CallumNunesVaz/OpenController/README.md

# OpenController

A cheap, open-source general purpose controller based on a ubiquitous co-processor model.
