CallumNunesVaz/OpenController/Output/Documents/Schematic Prints.PDF

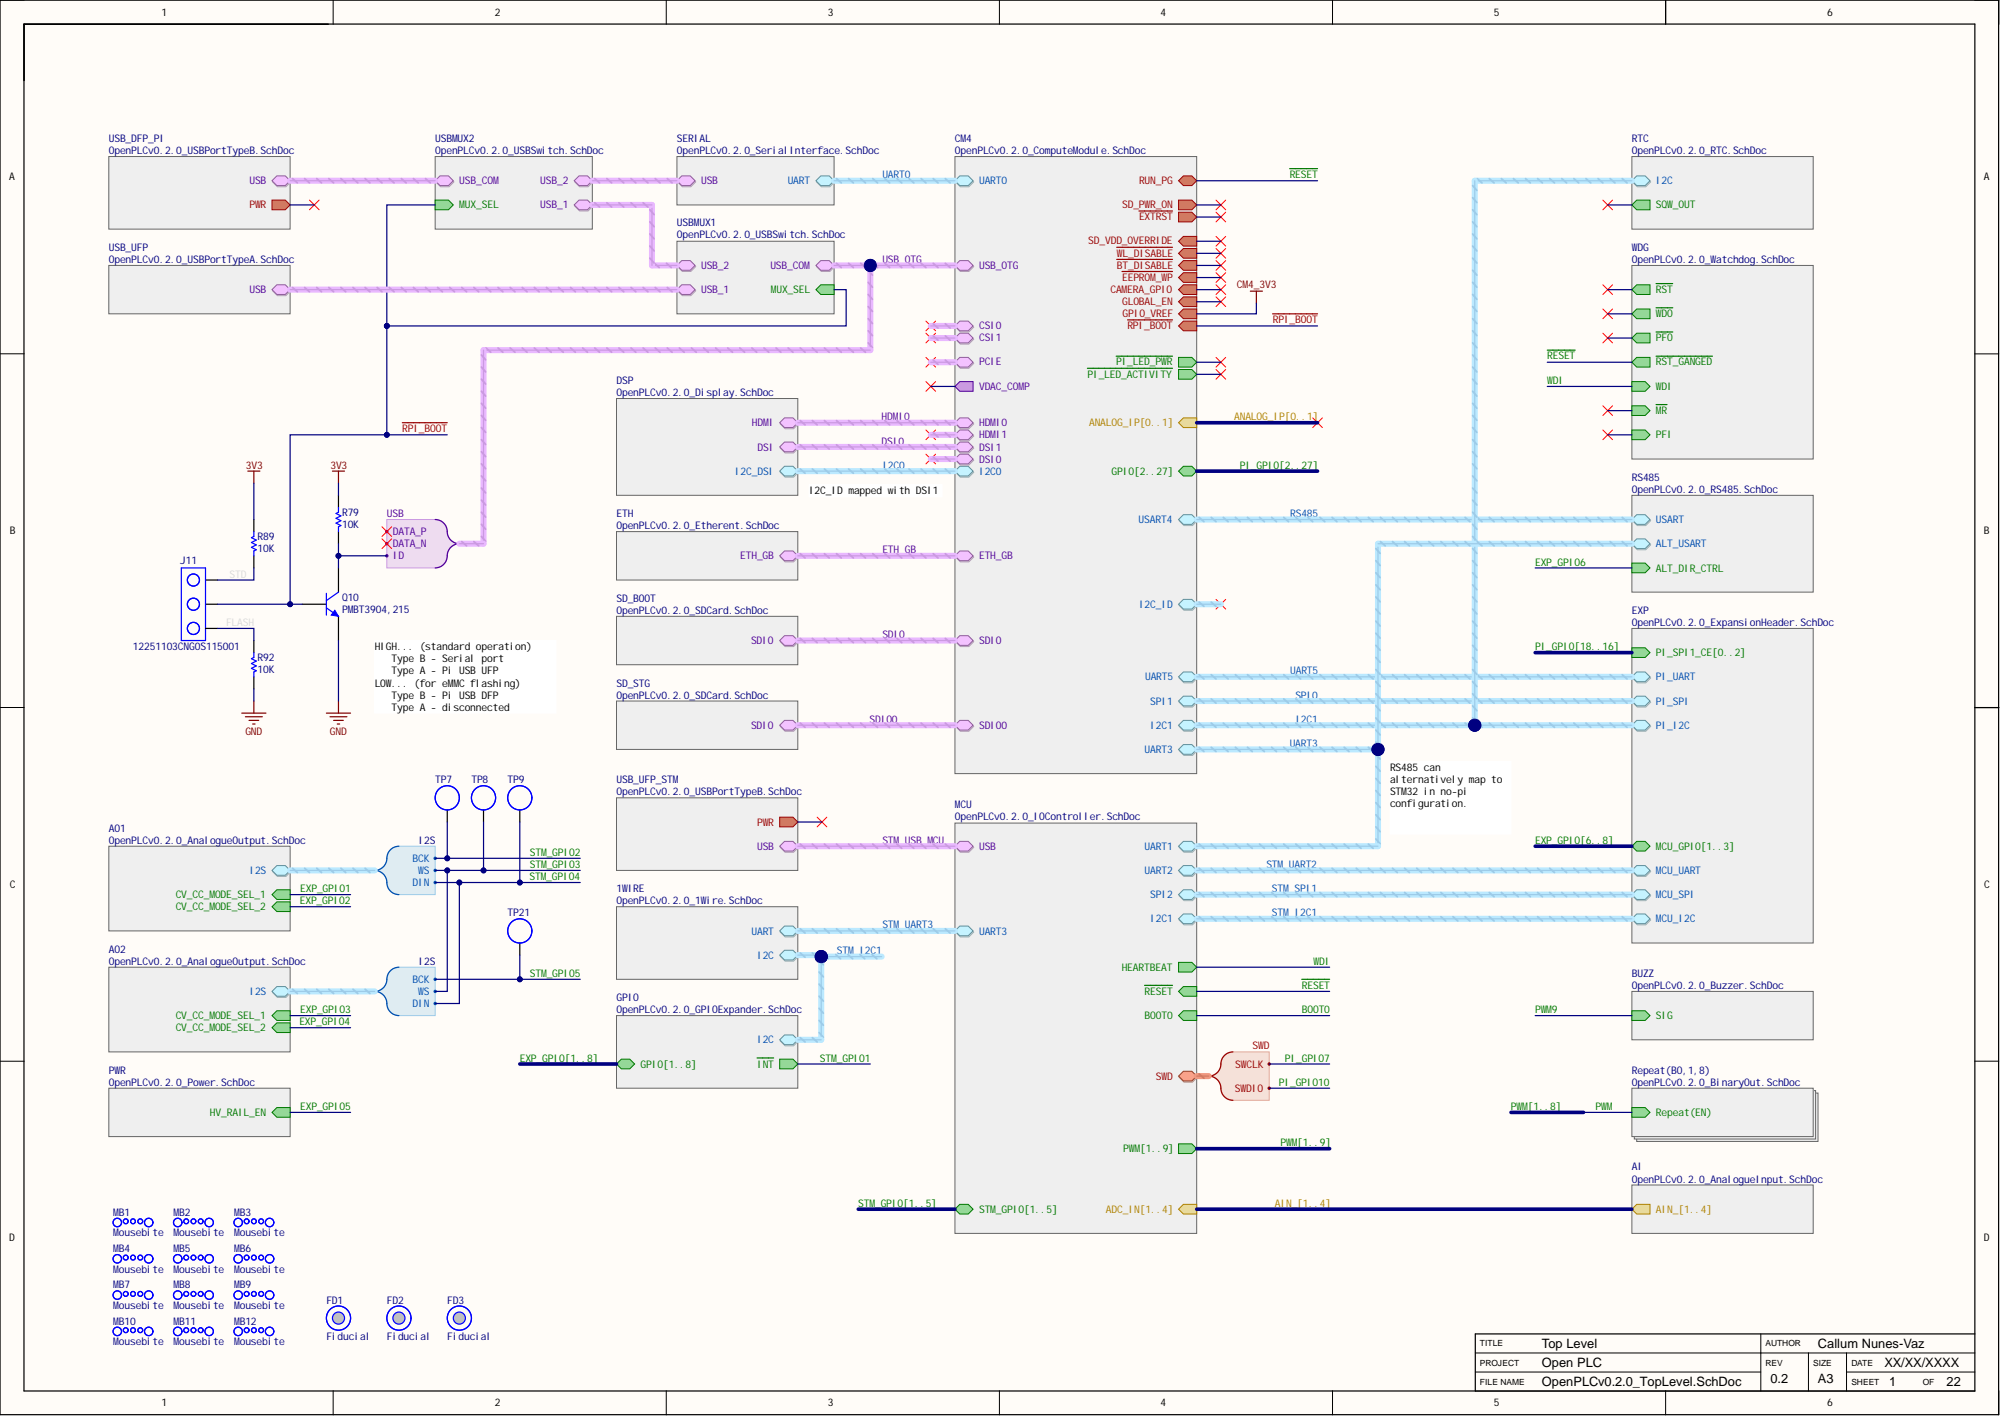
[picture p1: page 1]

HIGH... (standard operation)
Type B - Serial port
Type A - Pi USB UFP
LOW... (for eMMC flashing)
Type B - Pi USB DFP
Type A - disconnected

Top Level TITLE | Callum Nunes-Vaz AUTHOR

PROJECT Open PLC | REV | SIZE A3 | DATE XX/XX/XXXX
FILE NAME OpenPLCv0.2.0_TopLevel.SchDoc | | | SHEET 1 OF 22

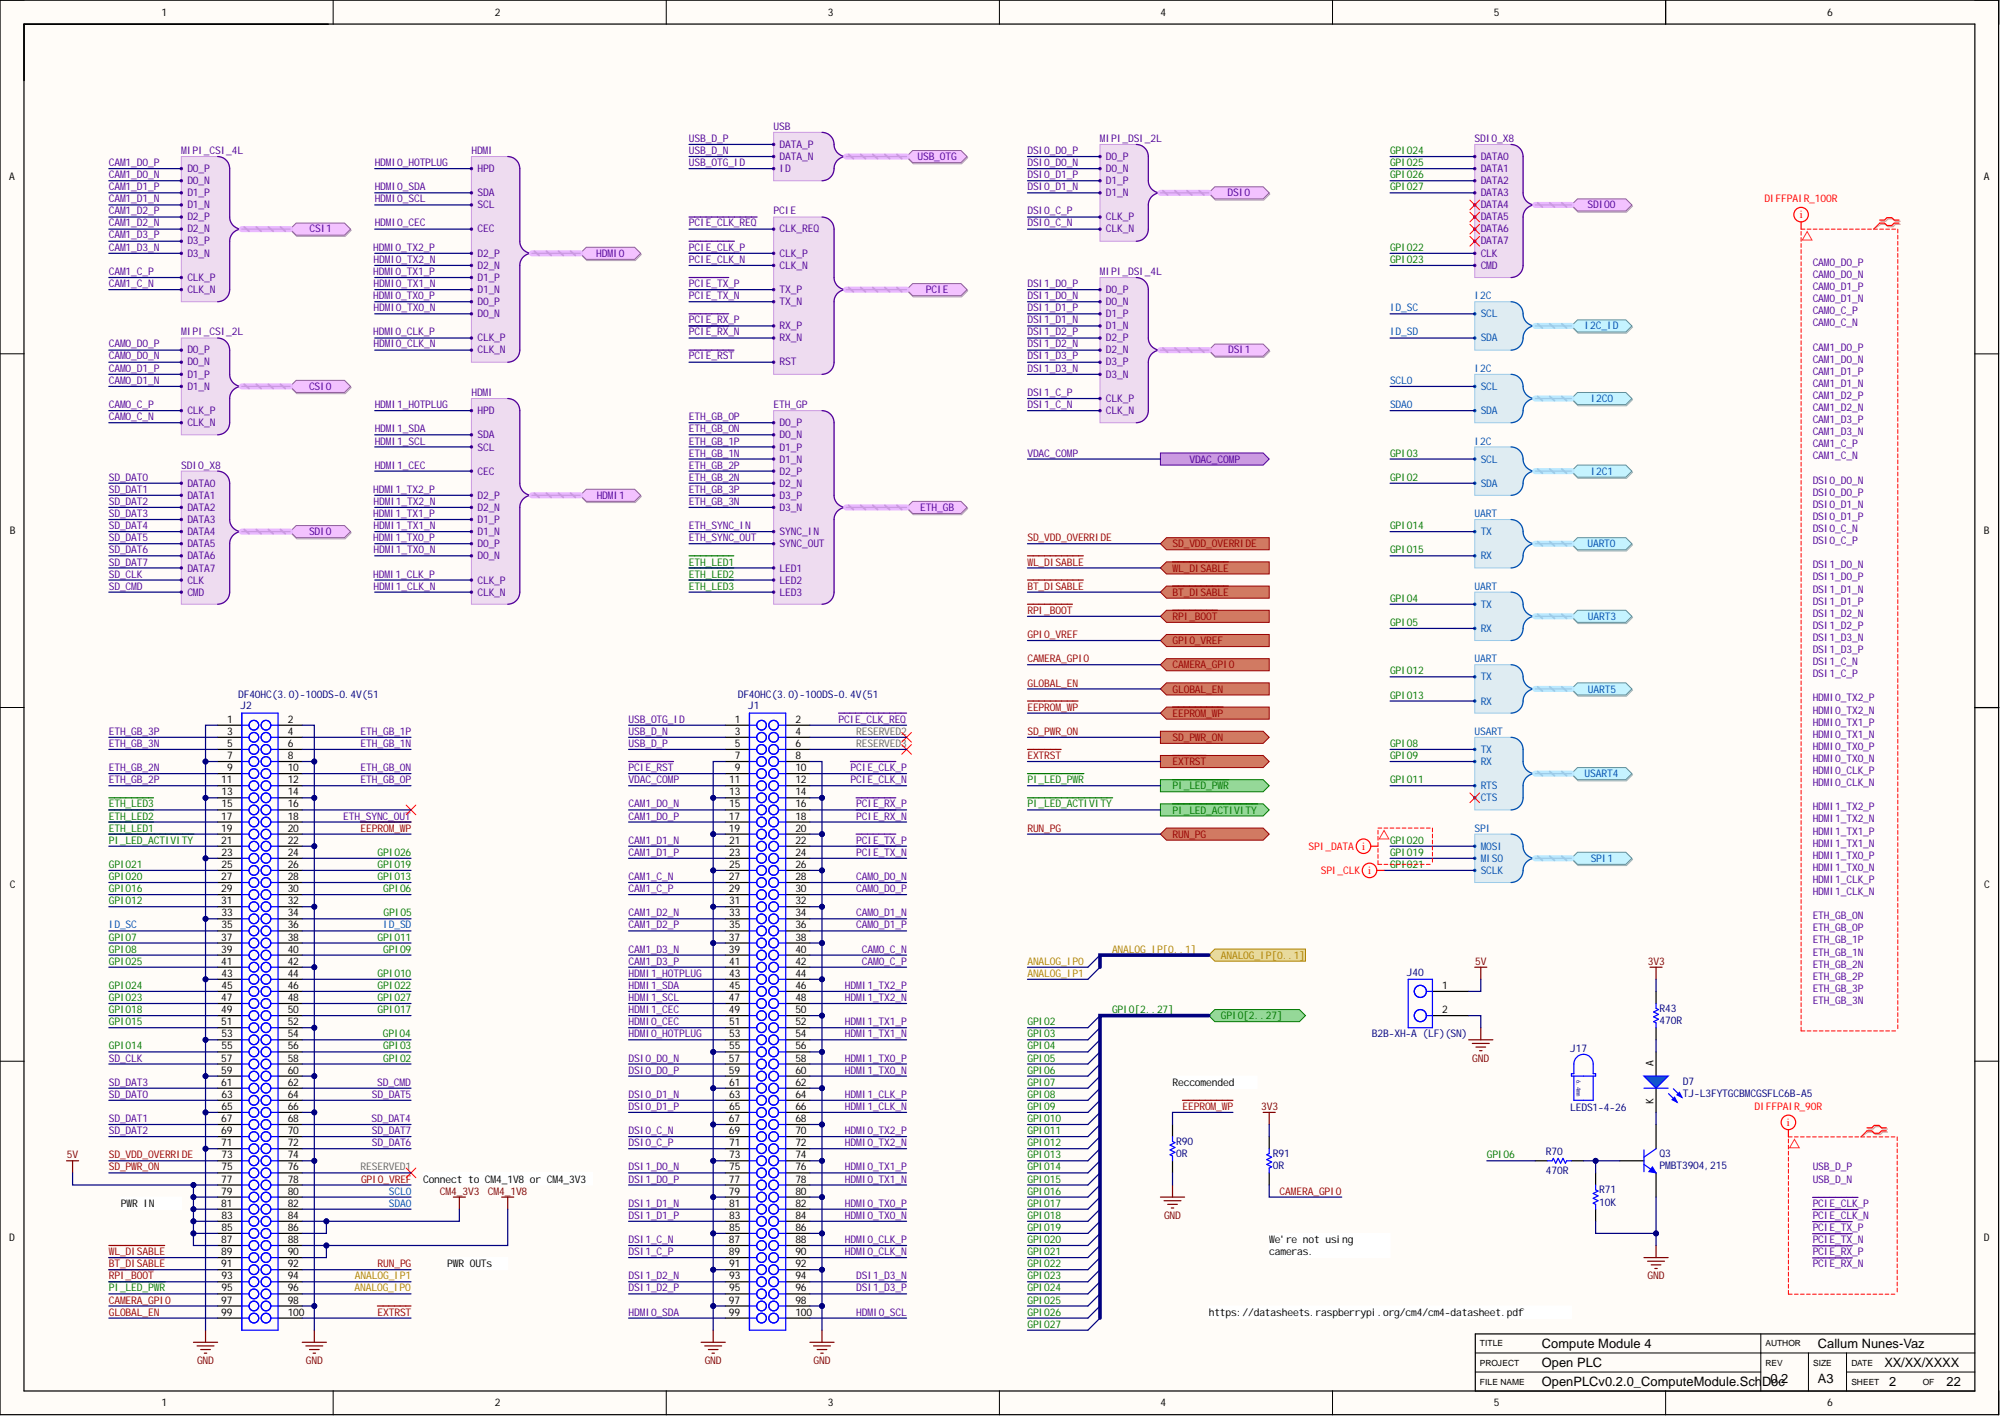
[picture p2: page 2]

Compute Module 4 TITL E | Callum Nunes-Vaz AUTHO R

PRO JECT | REV | SIZE | DATE A3 X X/X

FILE NAM E OpenPLCv0.2.0_ComputeModule.SchDoc | | | SHEET O F 22

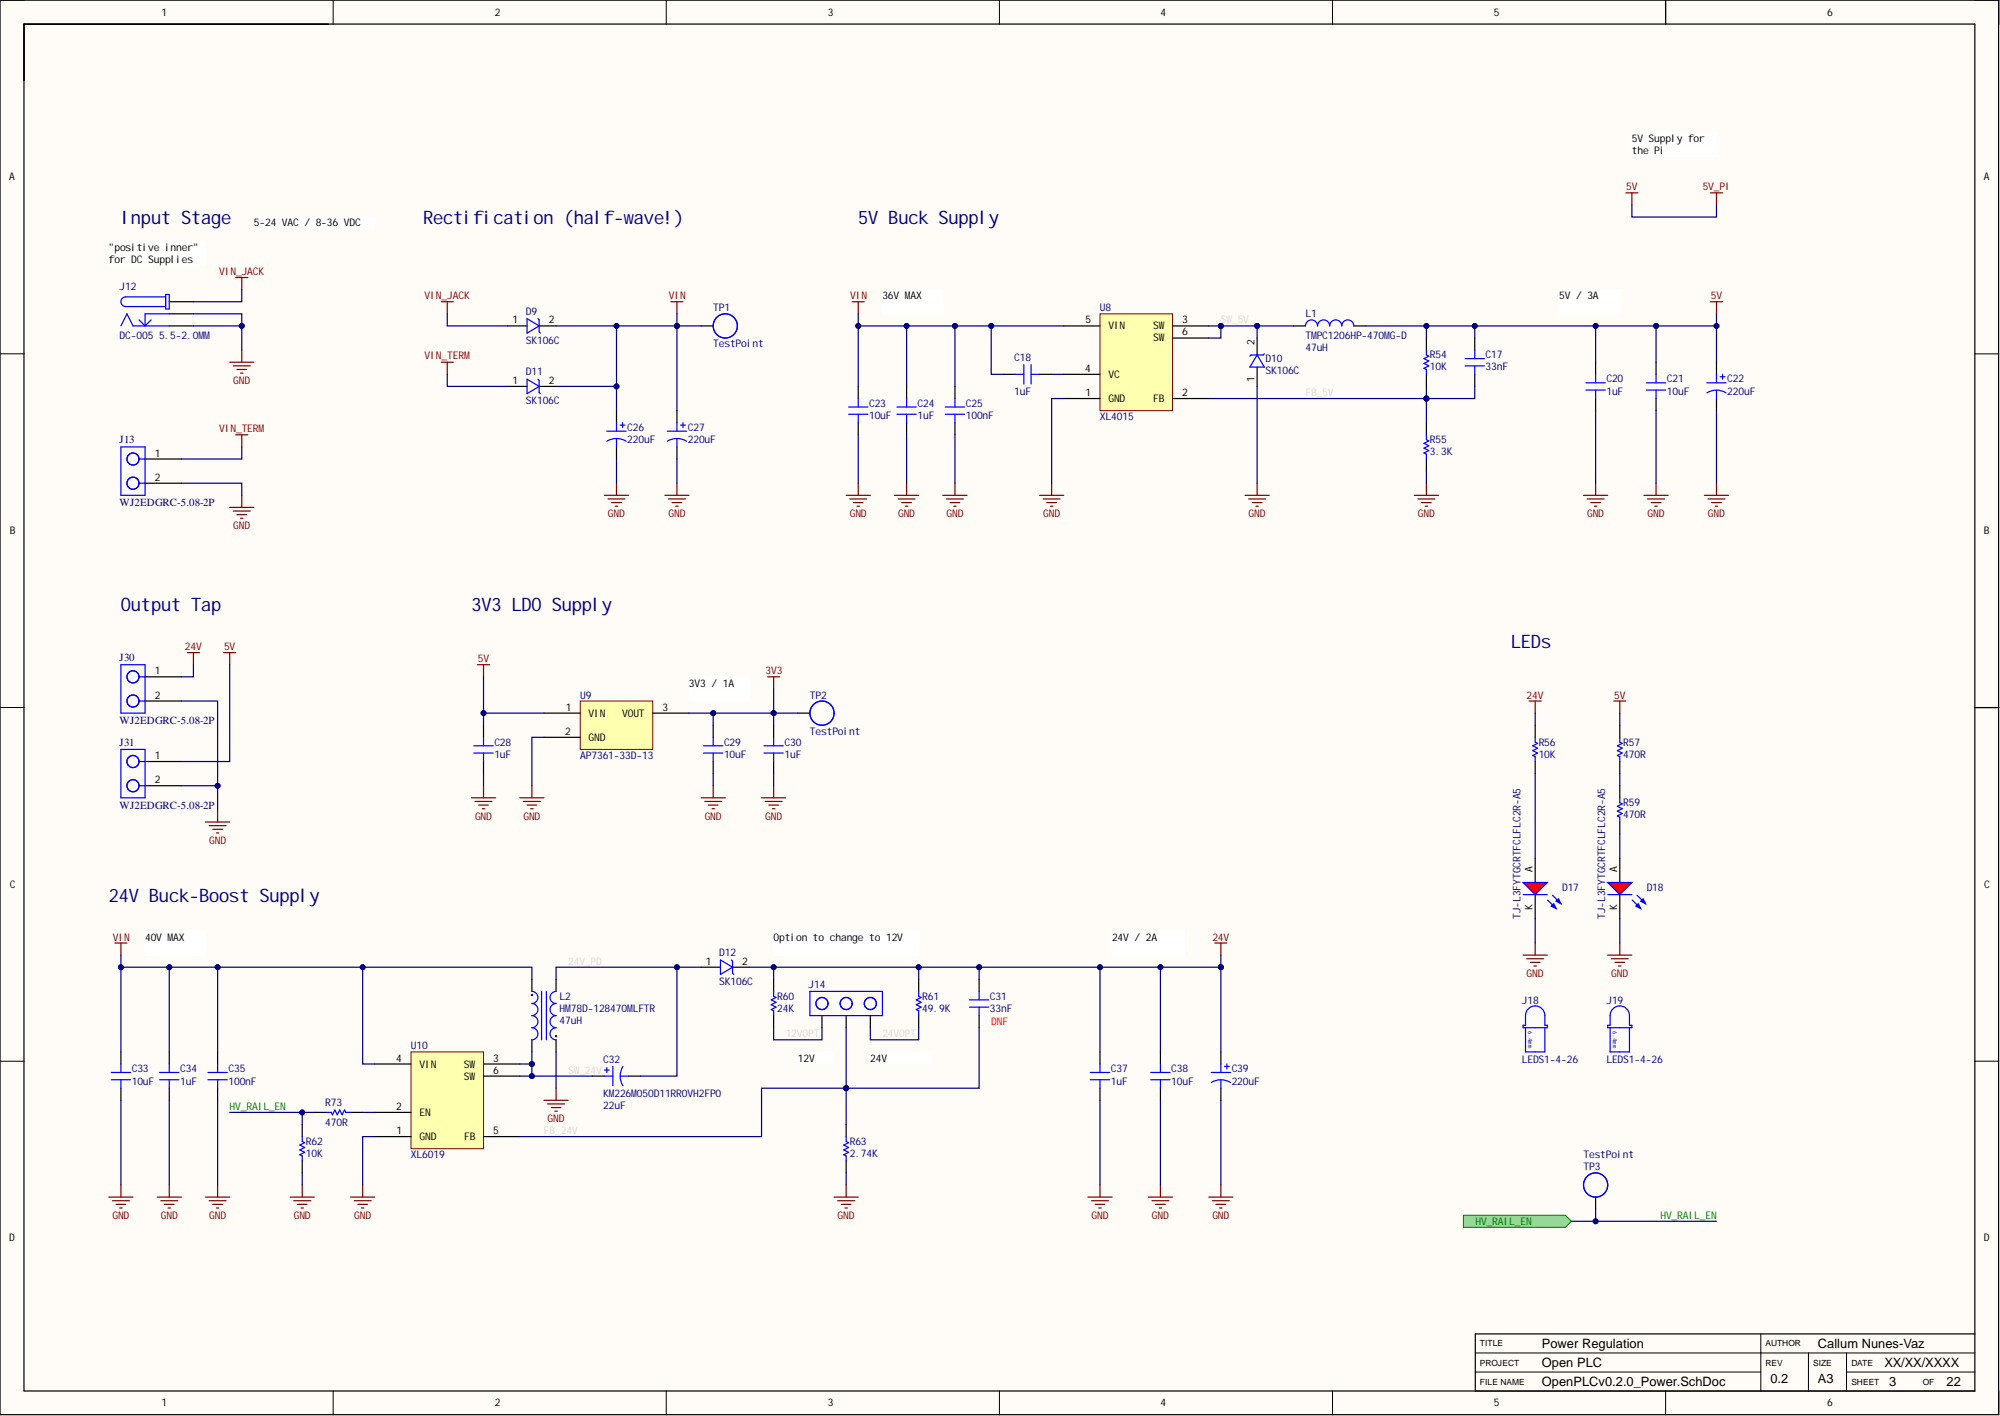
[picture p3: page 3]

Option to change to 12V

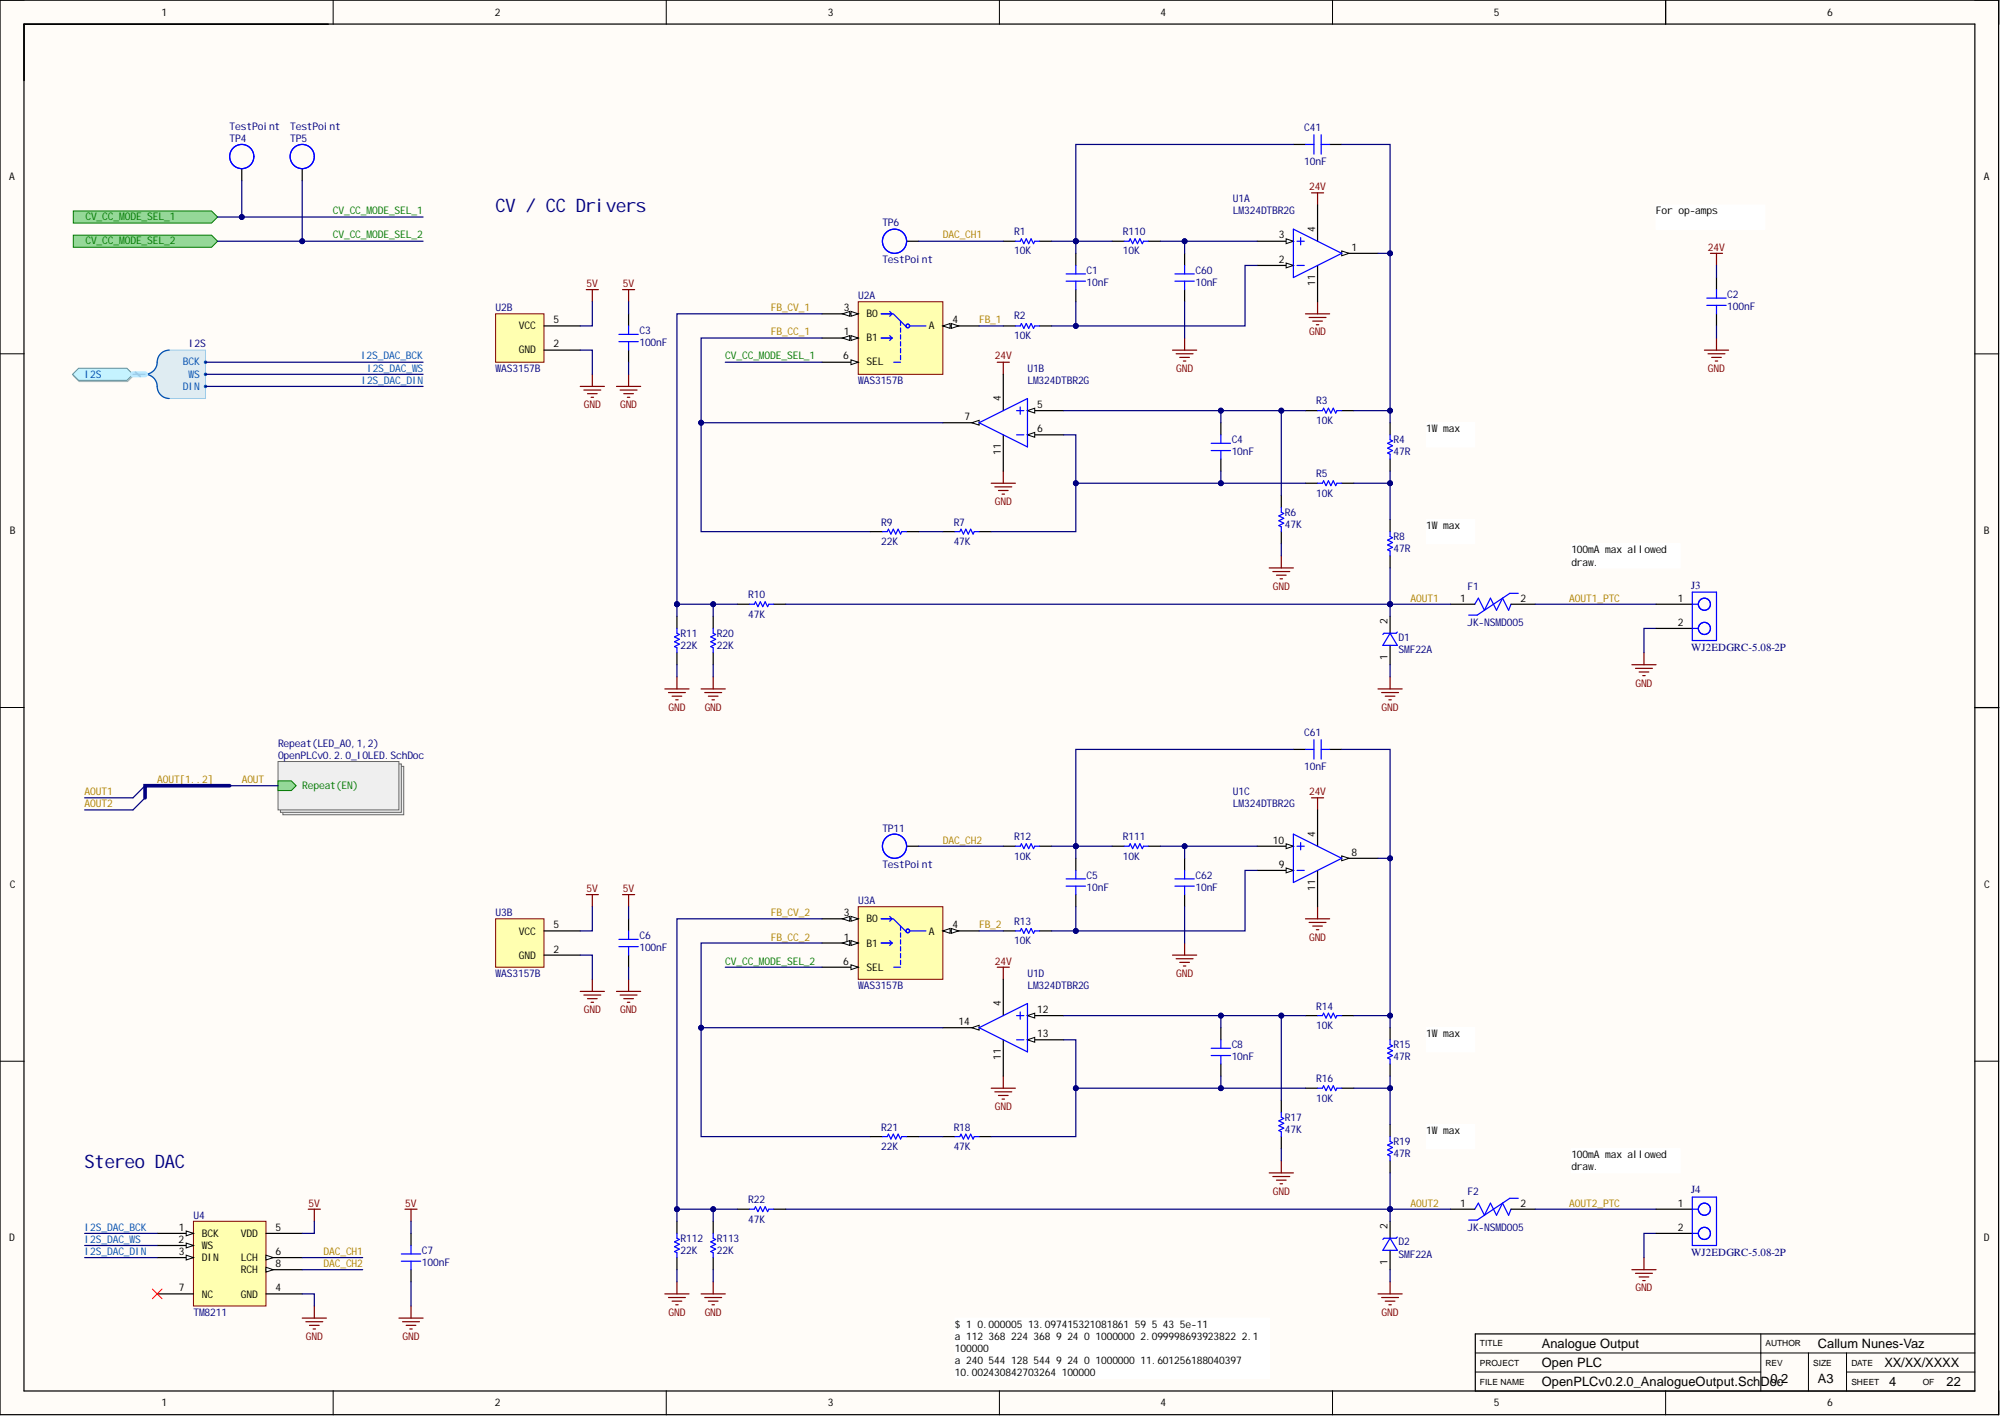
[picture p4: page 4]

CV_CC_MODE_SEL_1 | SEL 6

CV_CC_MODE_SEL_2 | SEL 6

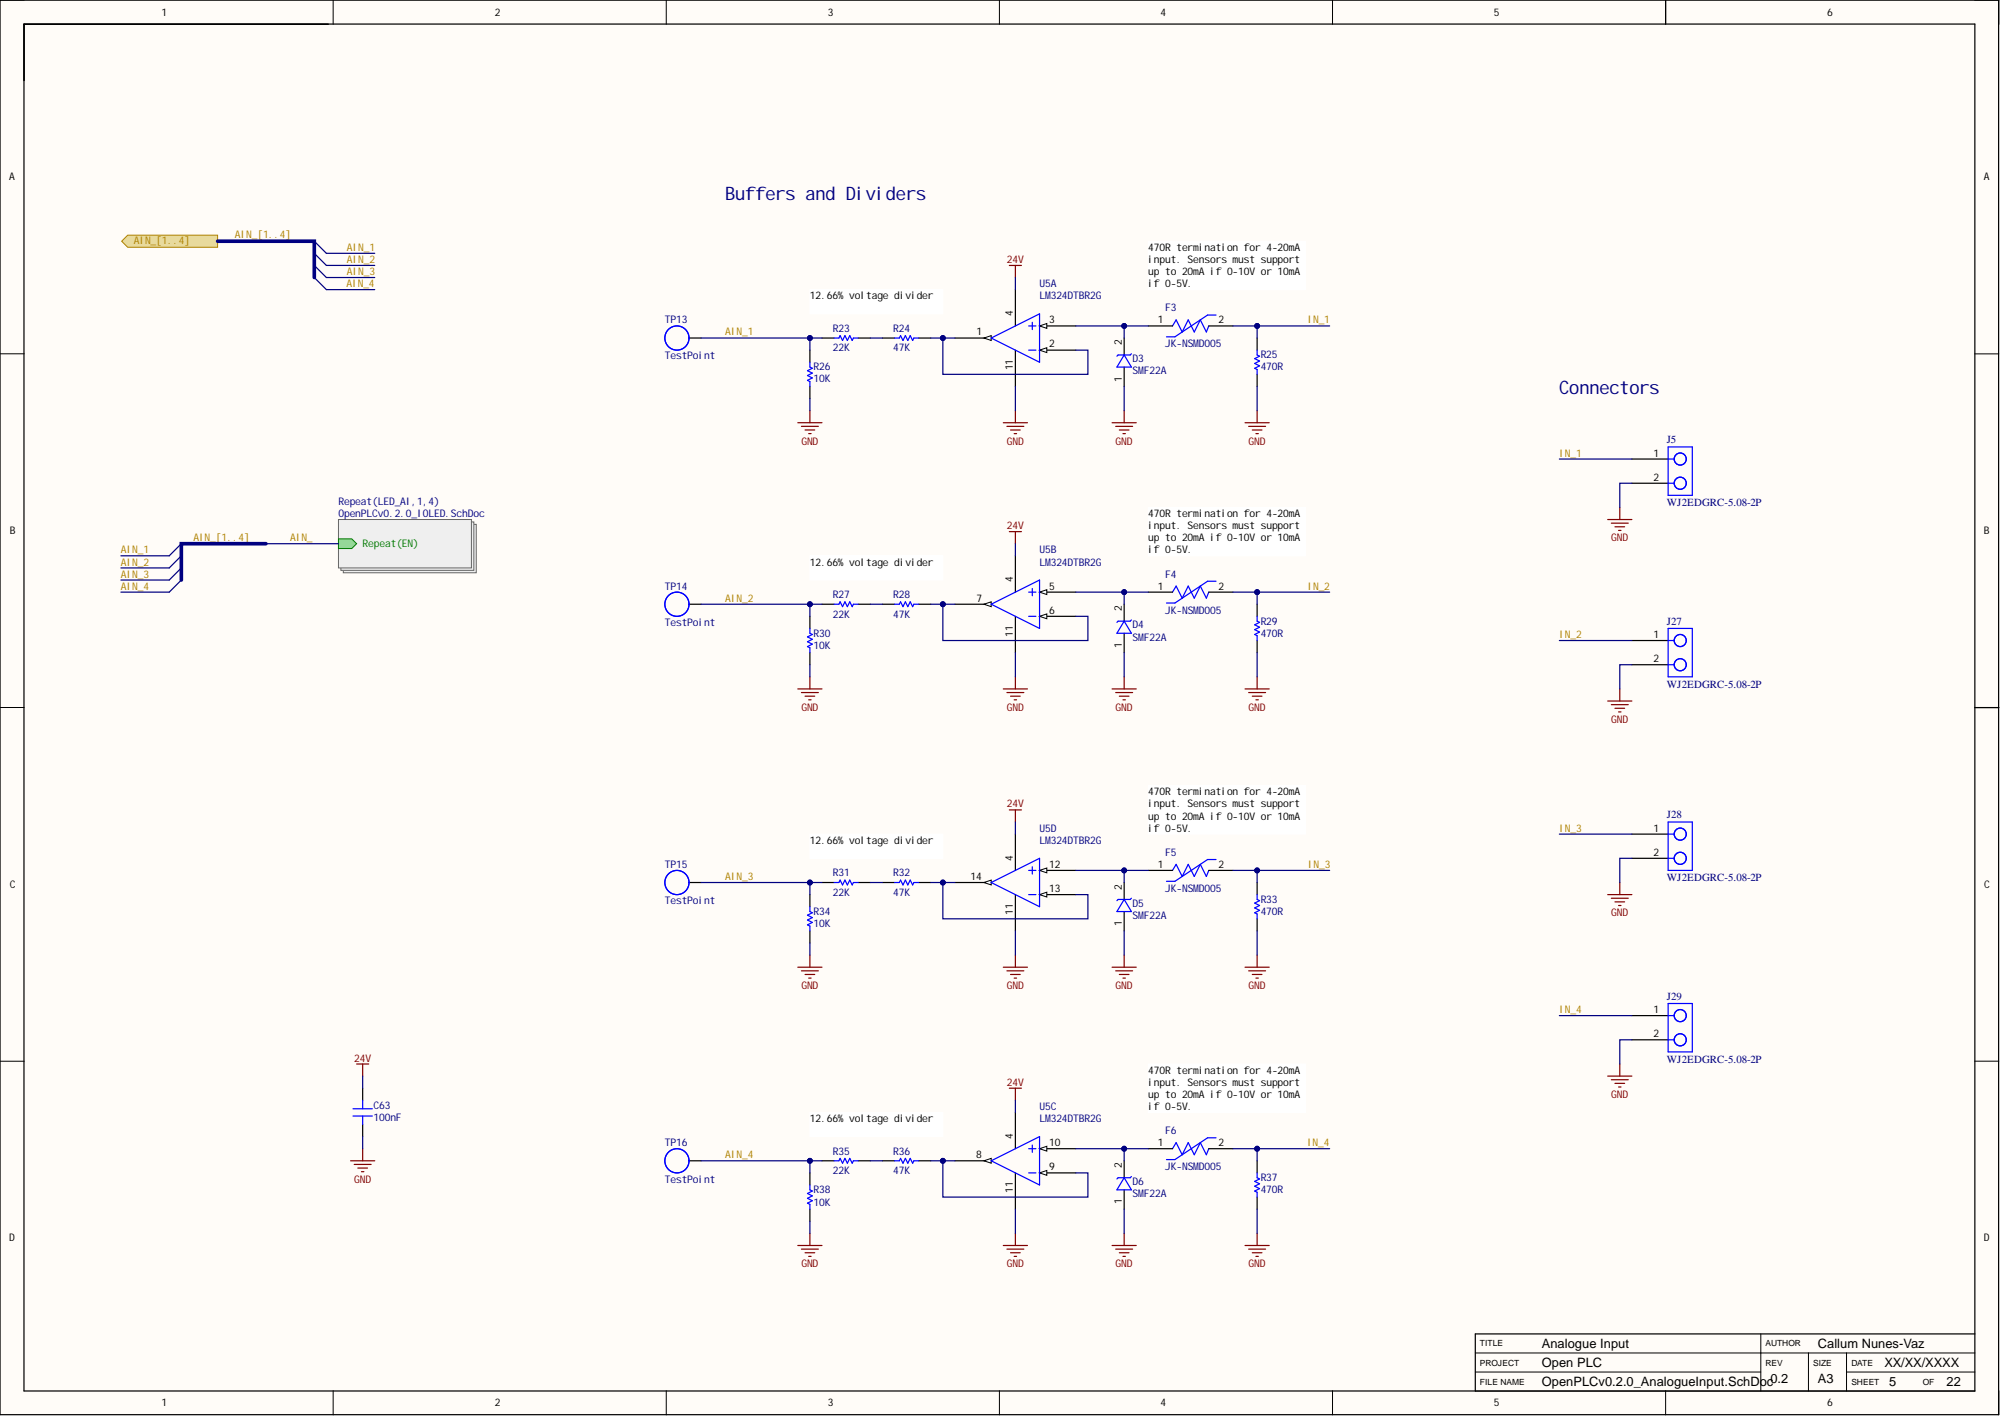
[picture p5: page 5]

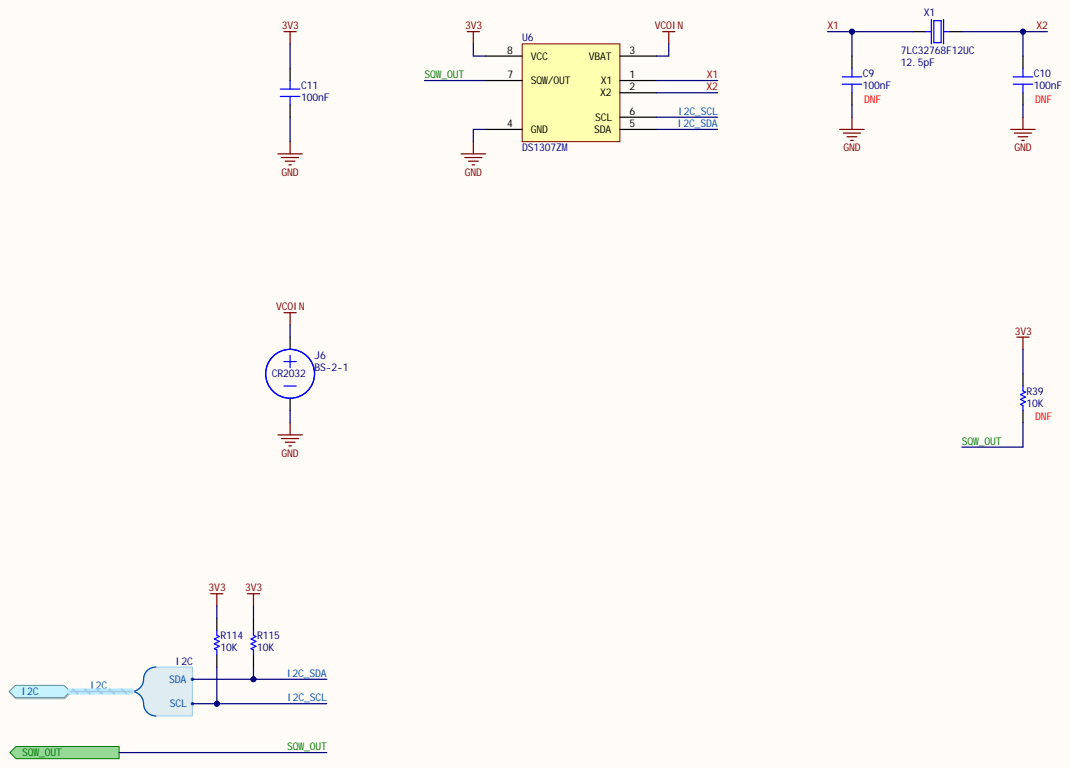
[picture p6: page 6]

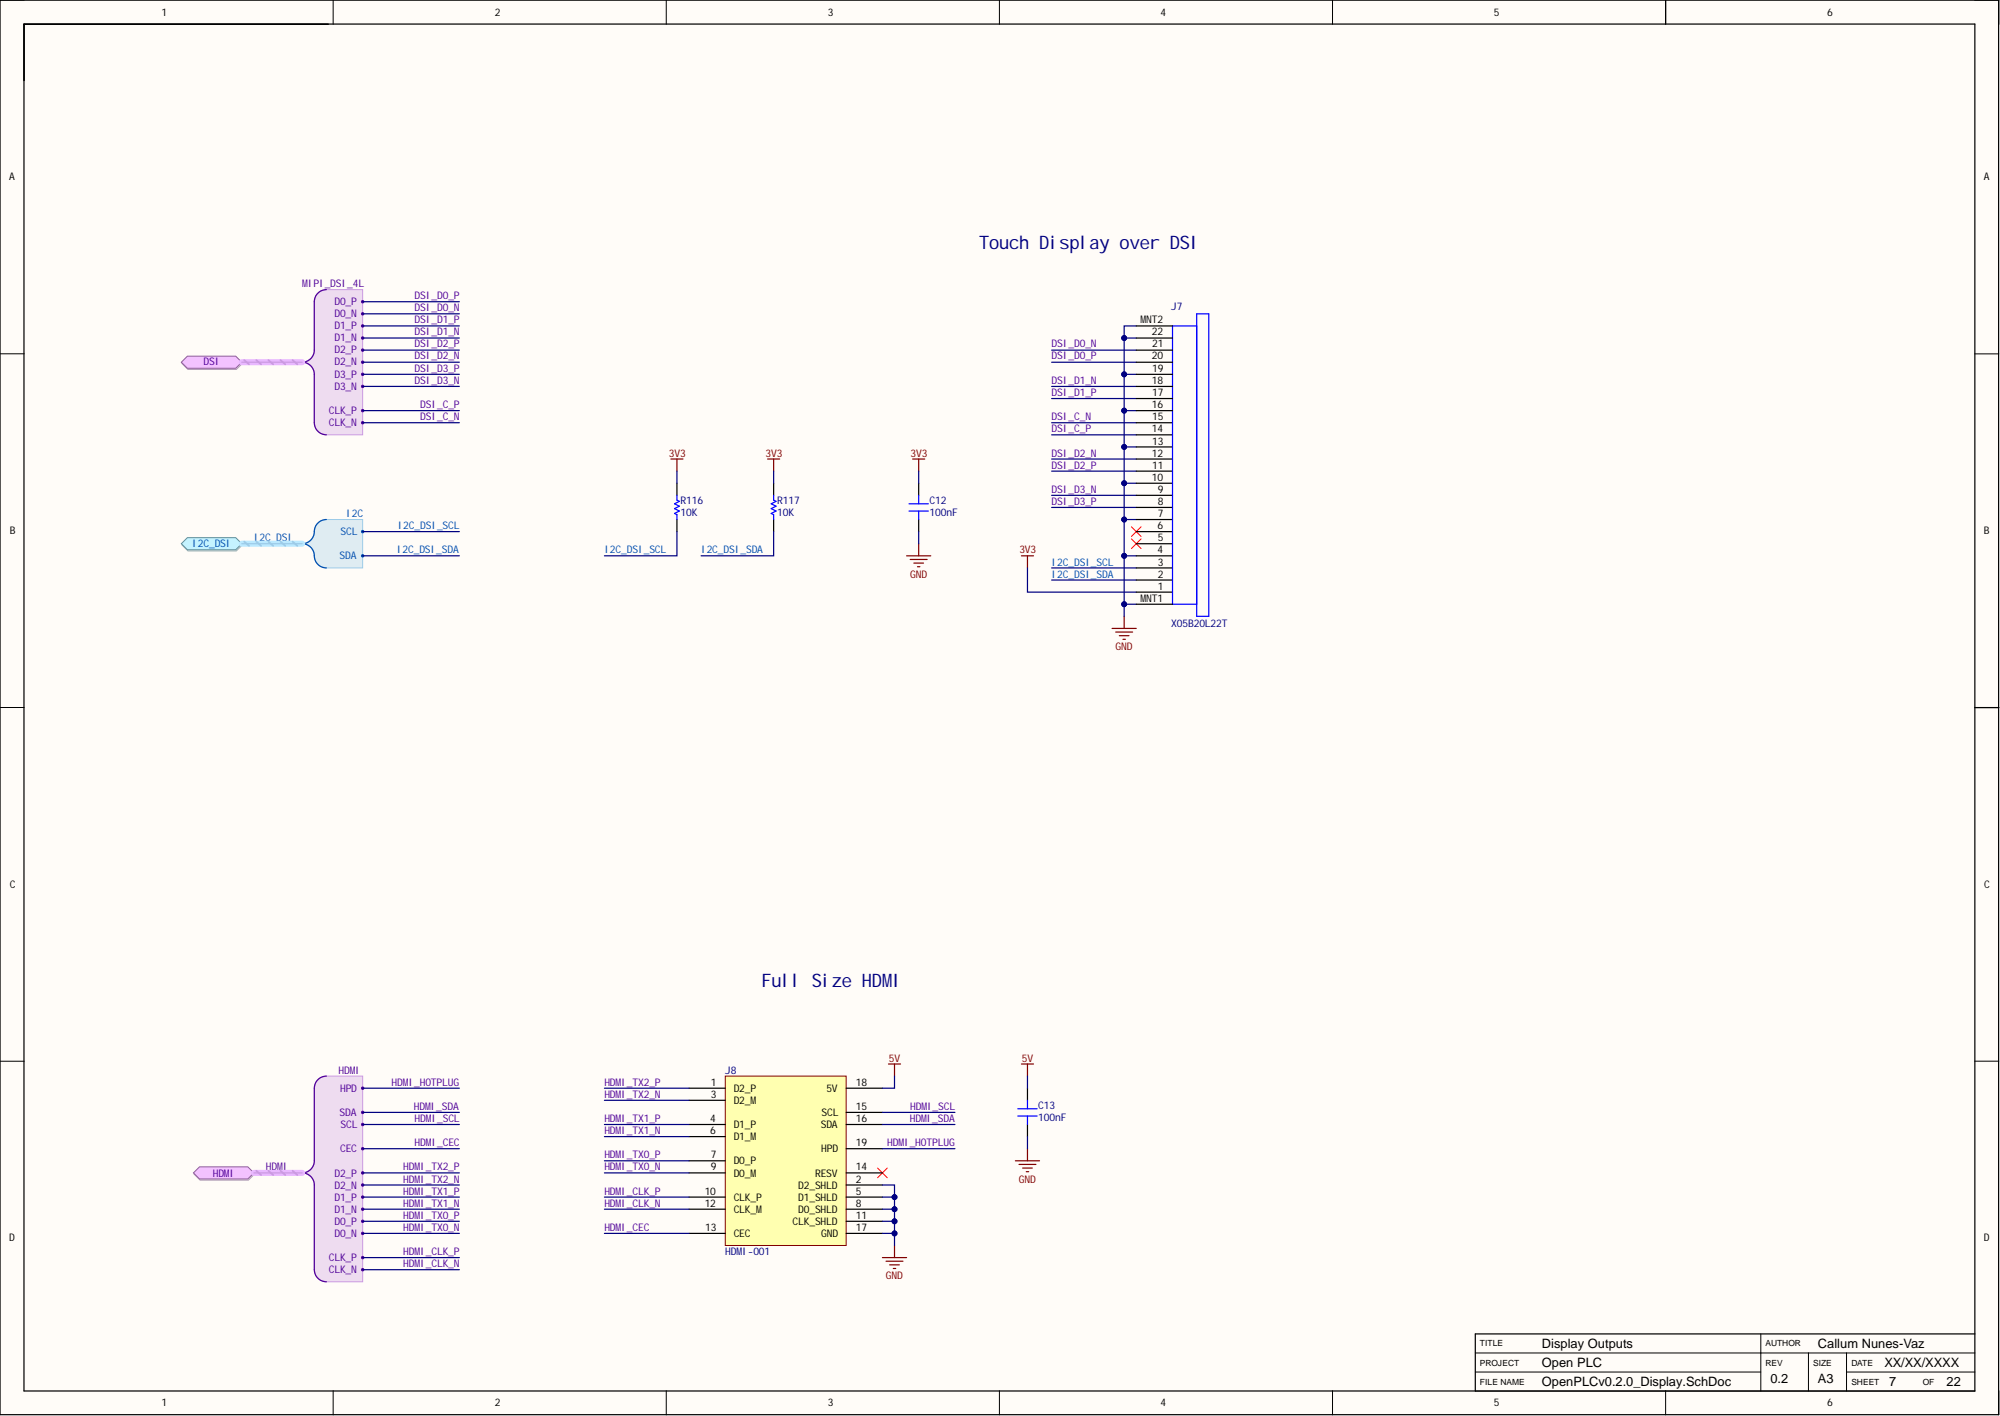
[picture p7: page 7]

Touch Display over DSI

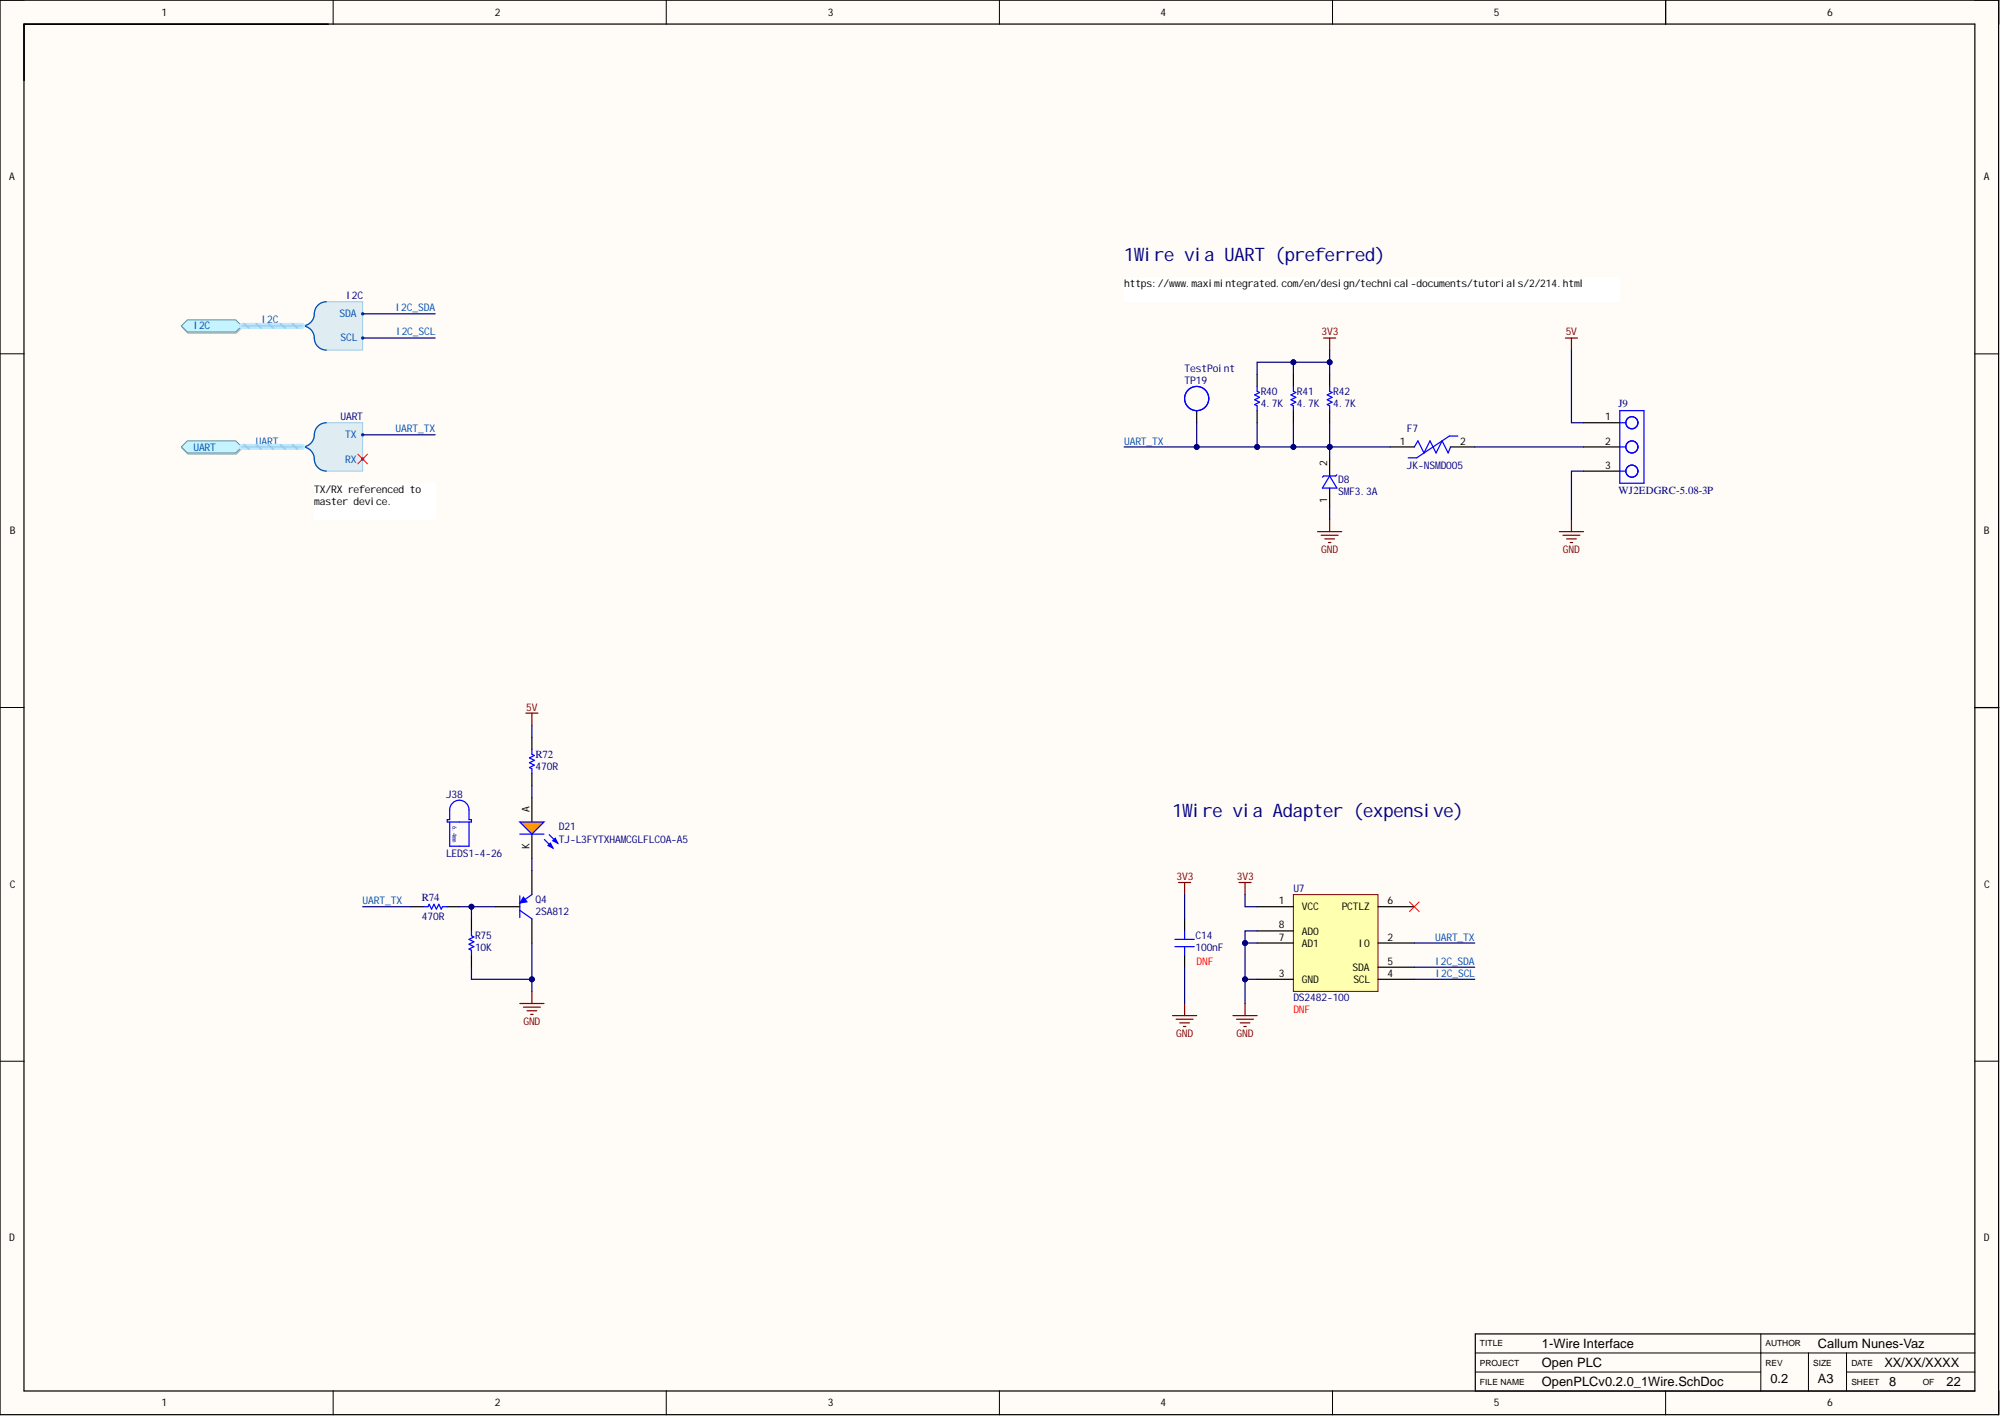
[picture p8: page 8]

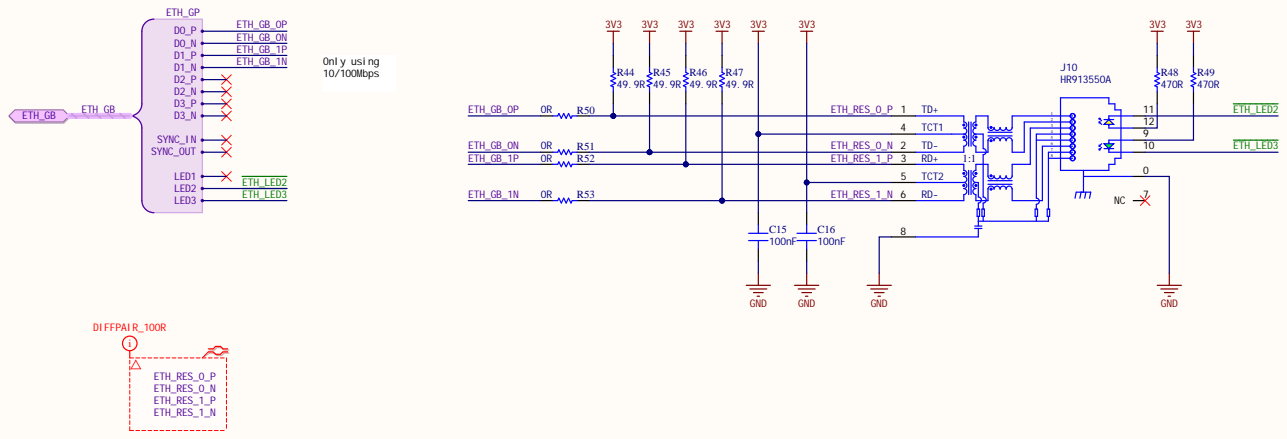
[picture p9: page 9]

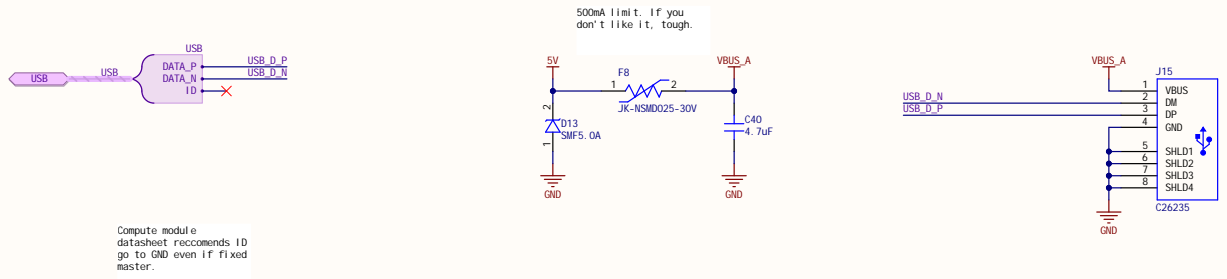
[picture p10: page 10]

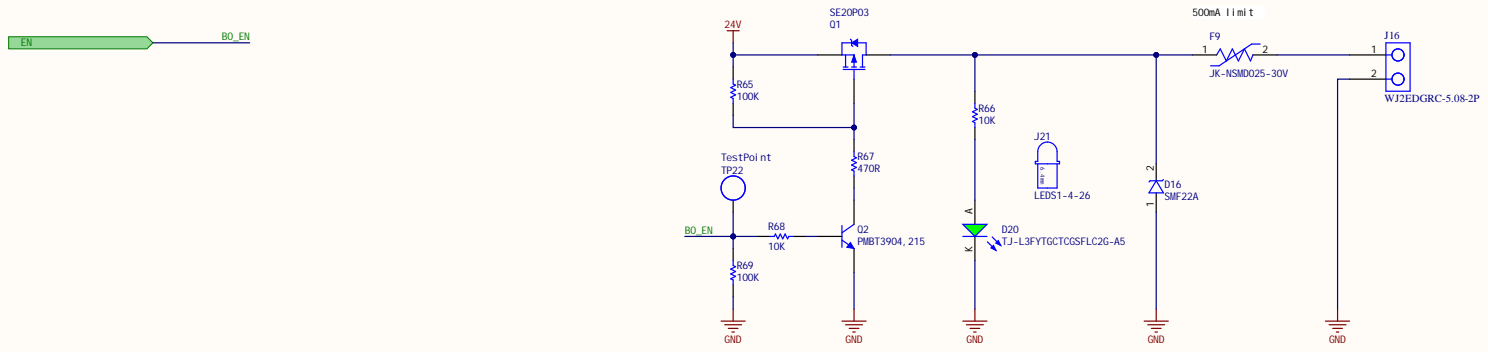
[picture p11: page 11]

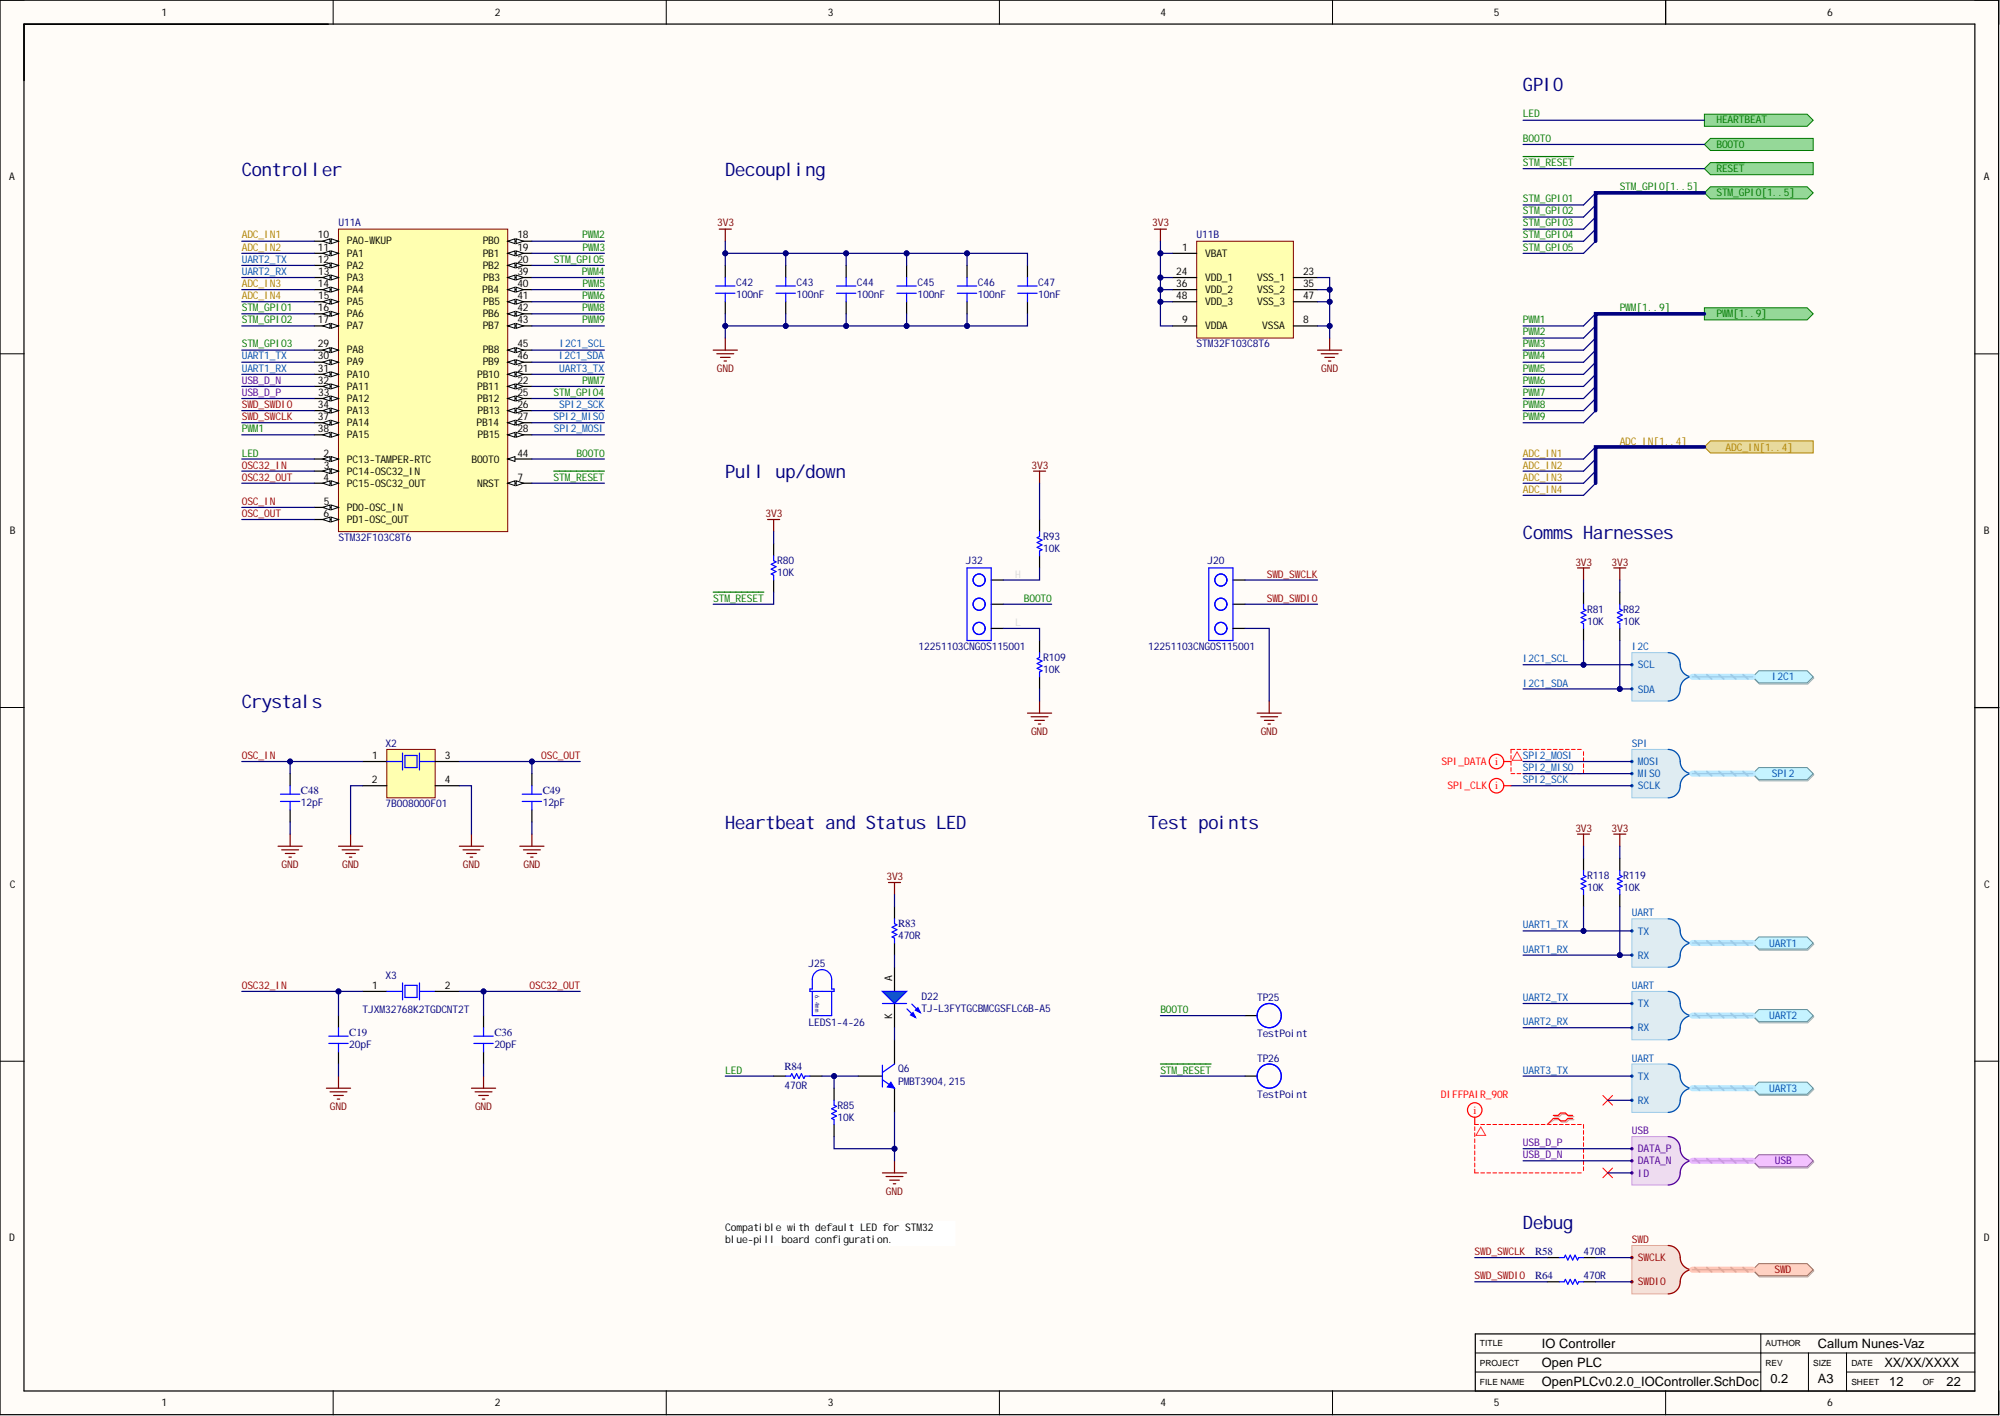
[picture p12: page 12]

Heartbeat and Status LED 10K R80

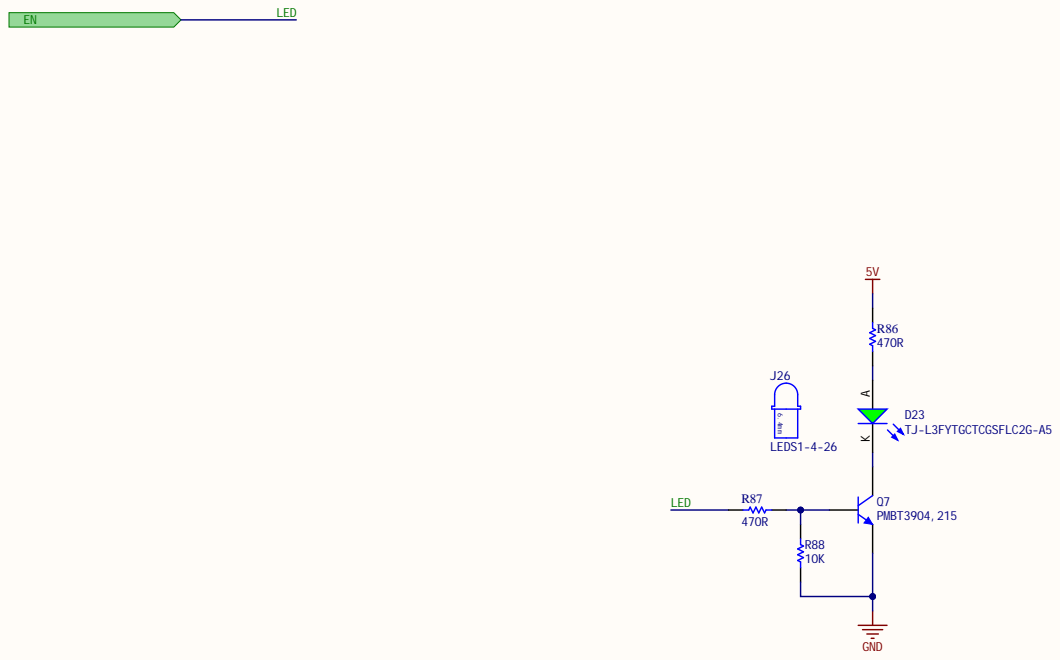
[picture p13: page 13]

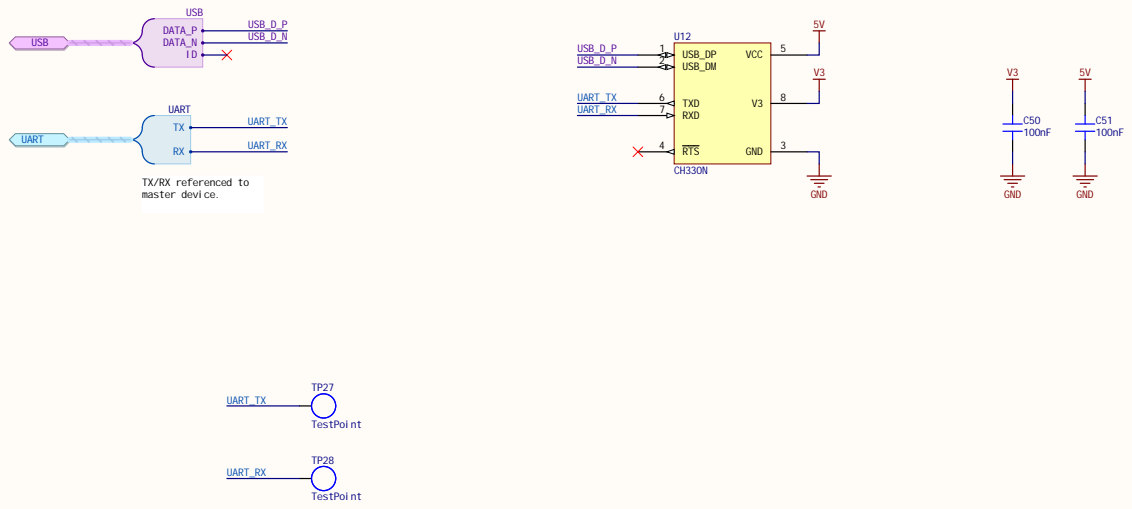
[picture p14: page 14]

TX/RX referenced to
master device.

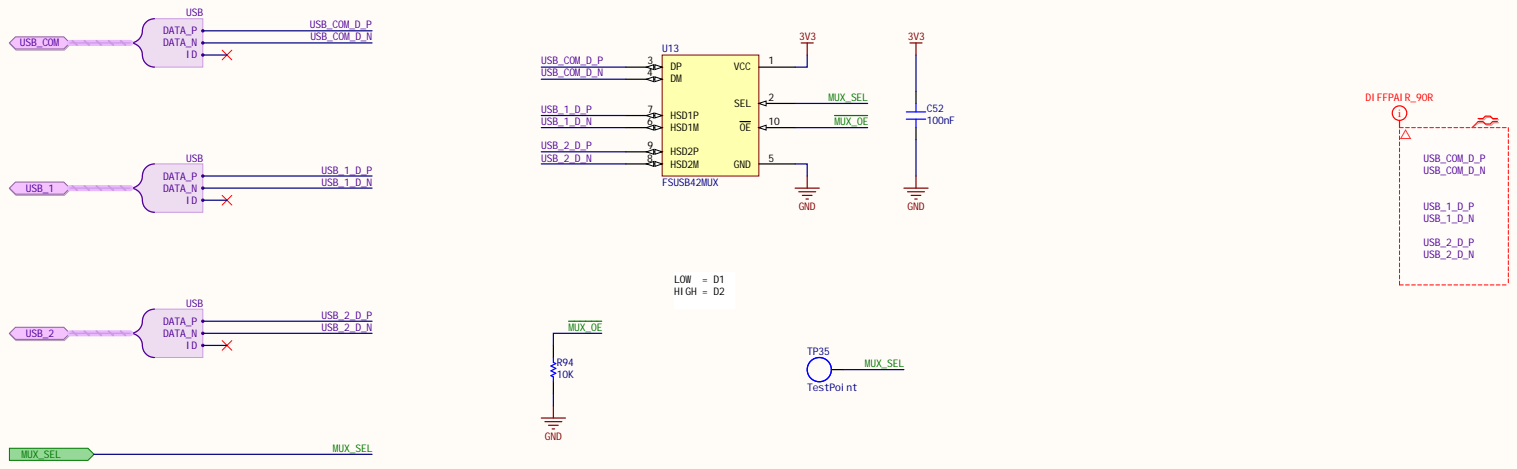
[picture p15: page 15]

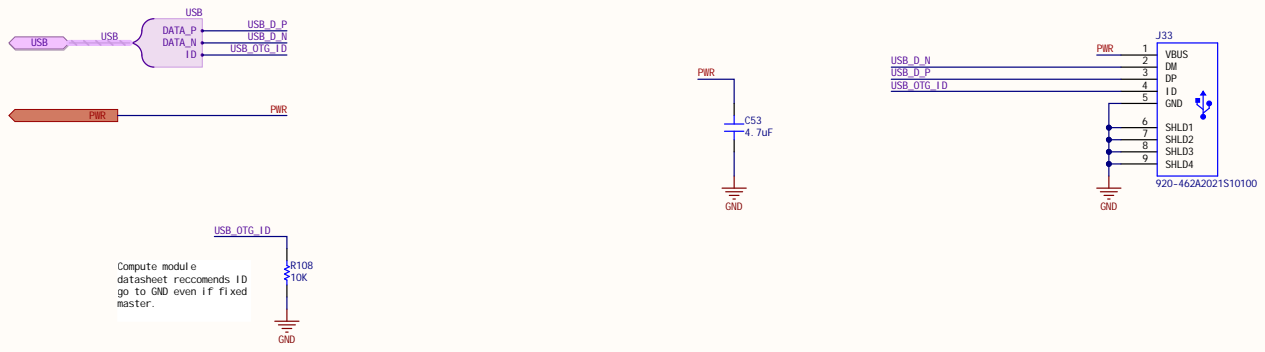
[picture p16: page 16]

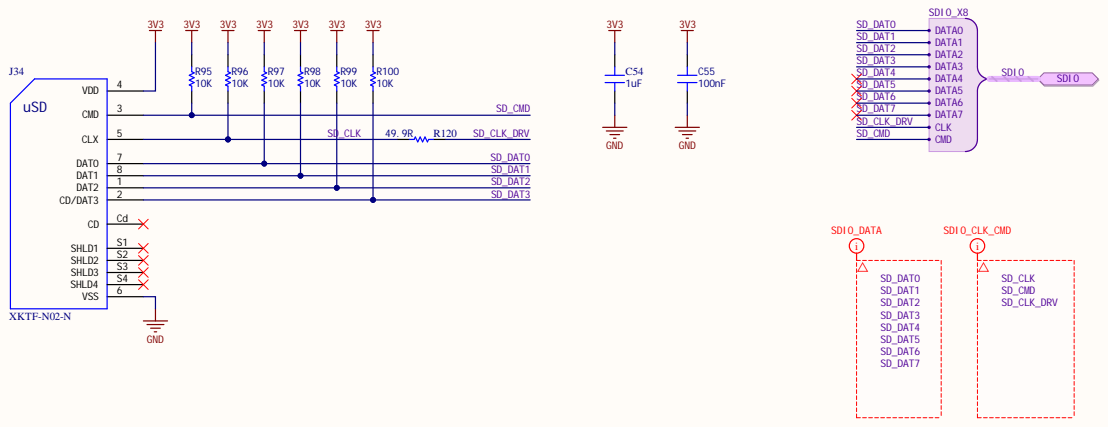
[picture p17: page 17]

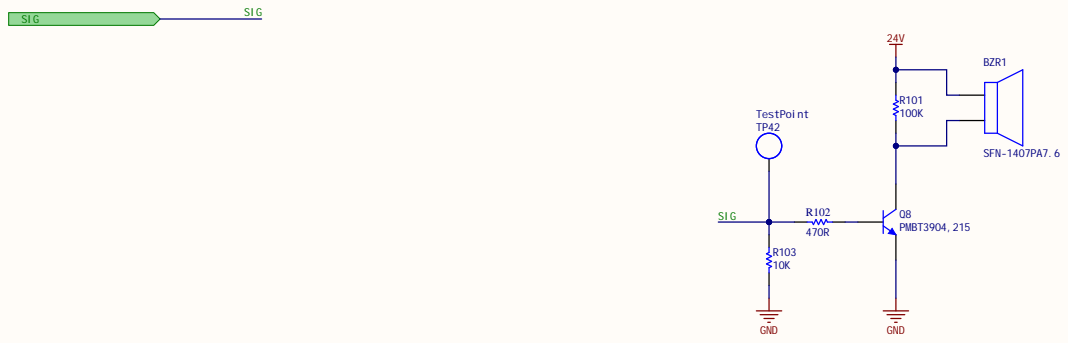
[picture p18: page 18]

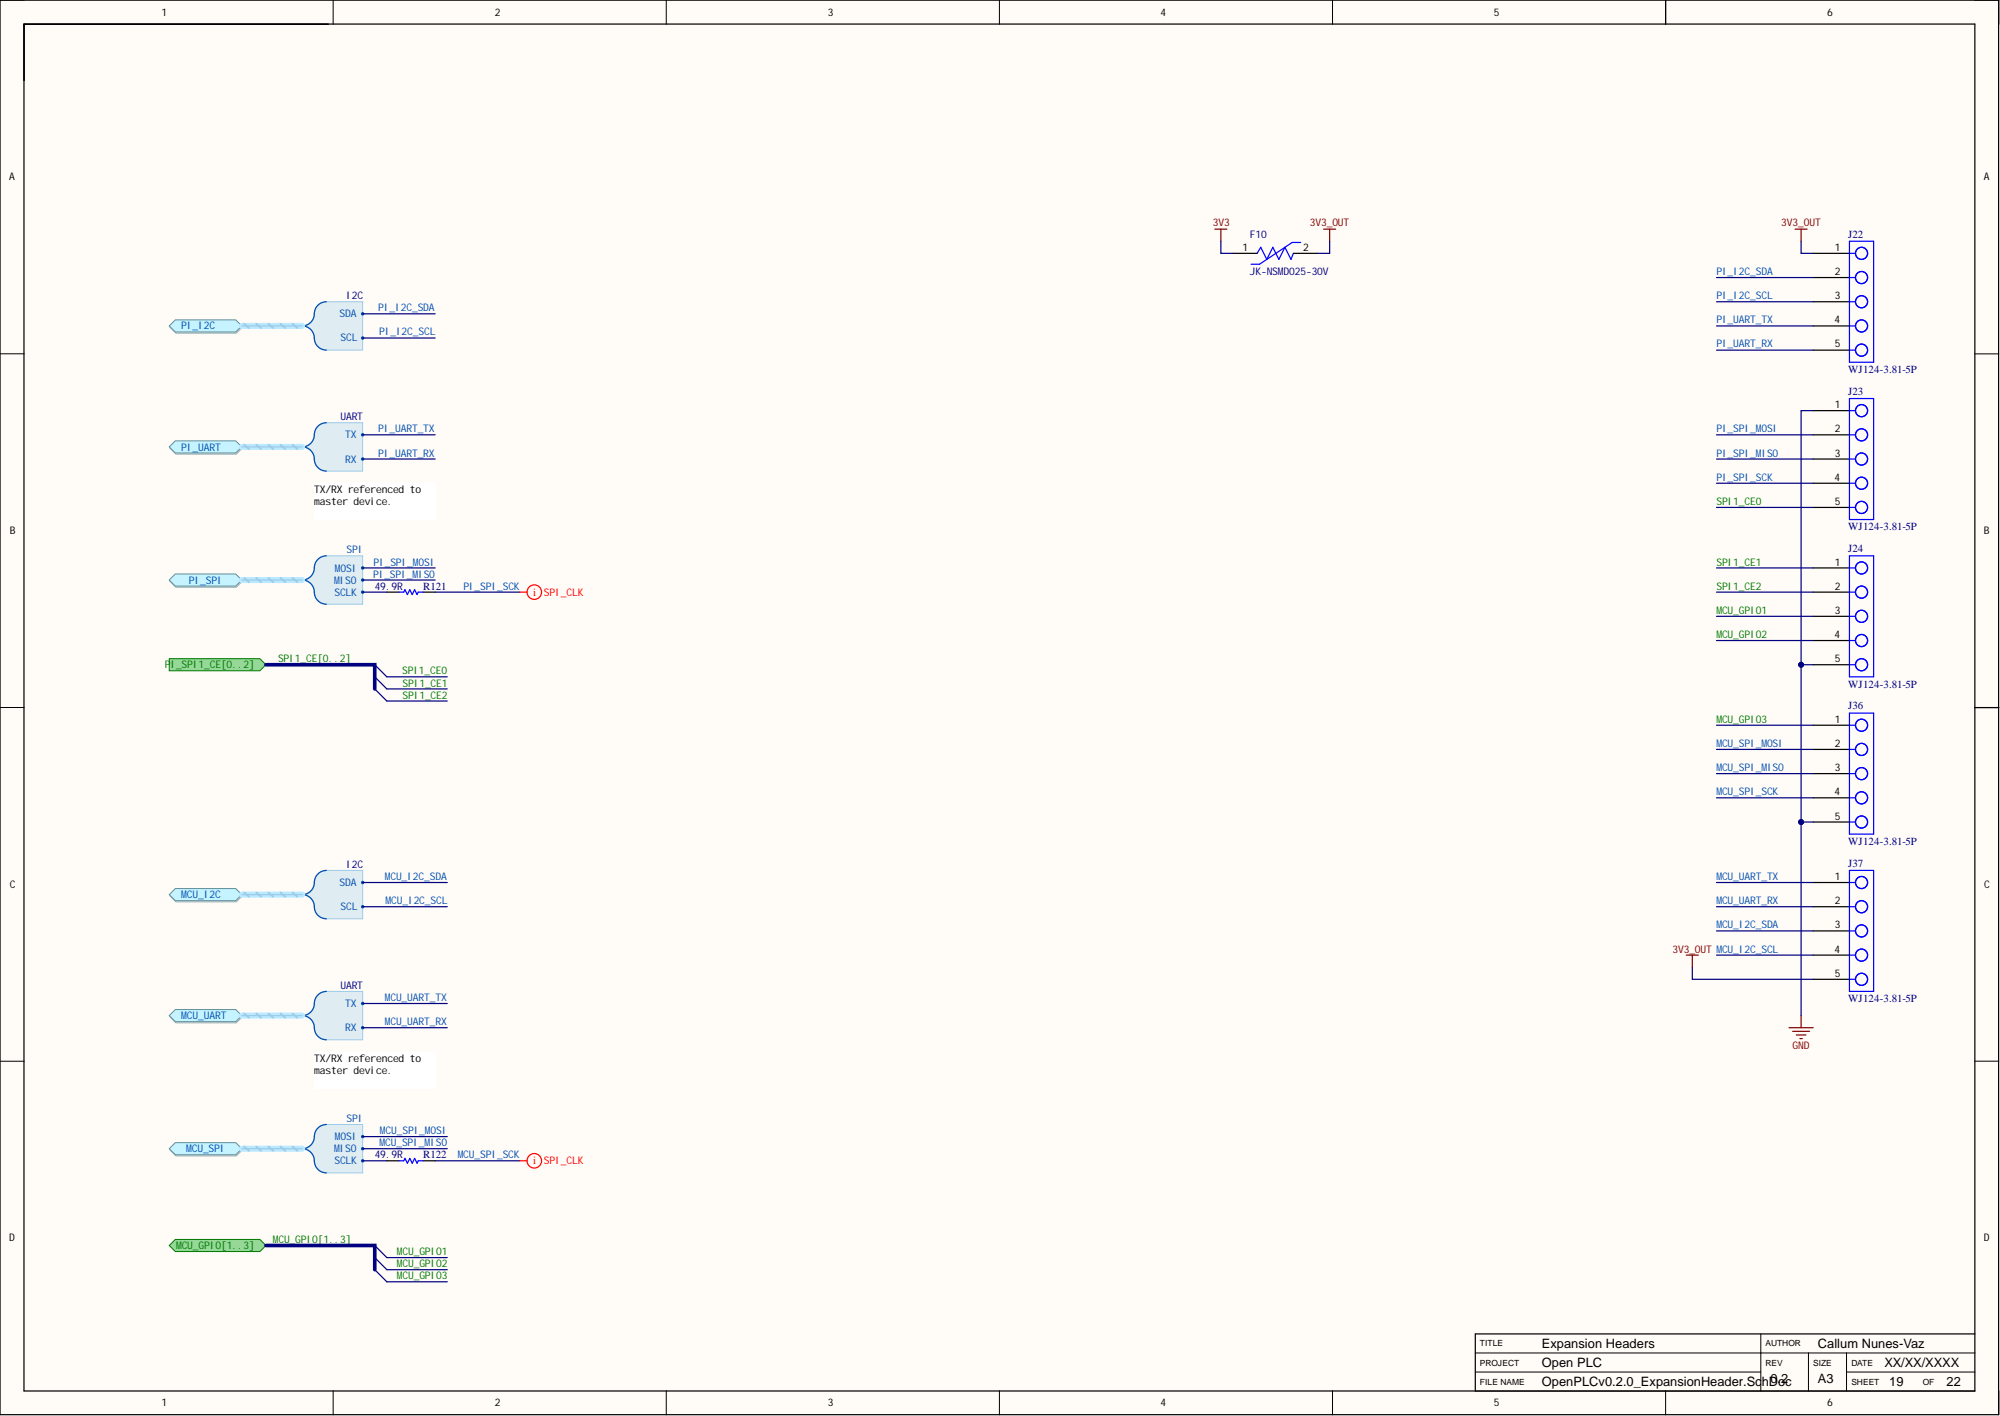
[picture p19: page 19]

Open PLC Expansion Header

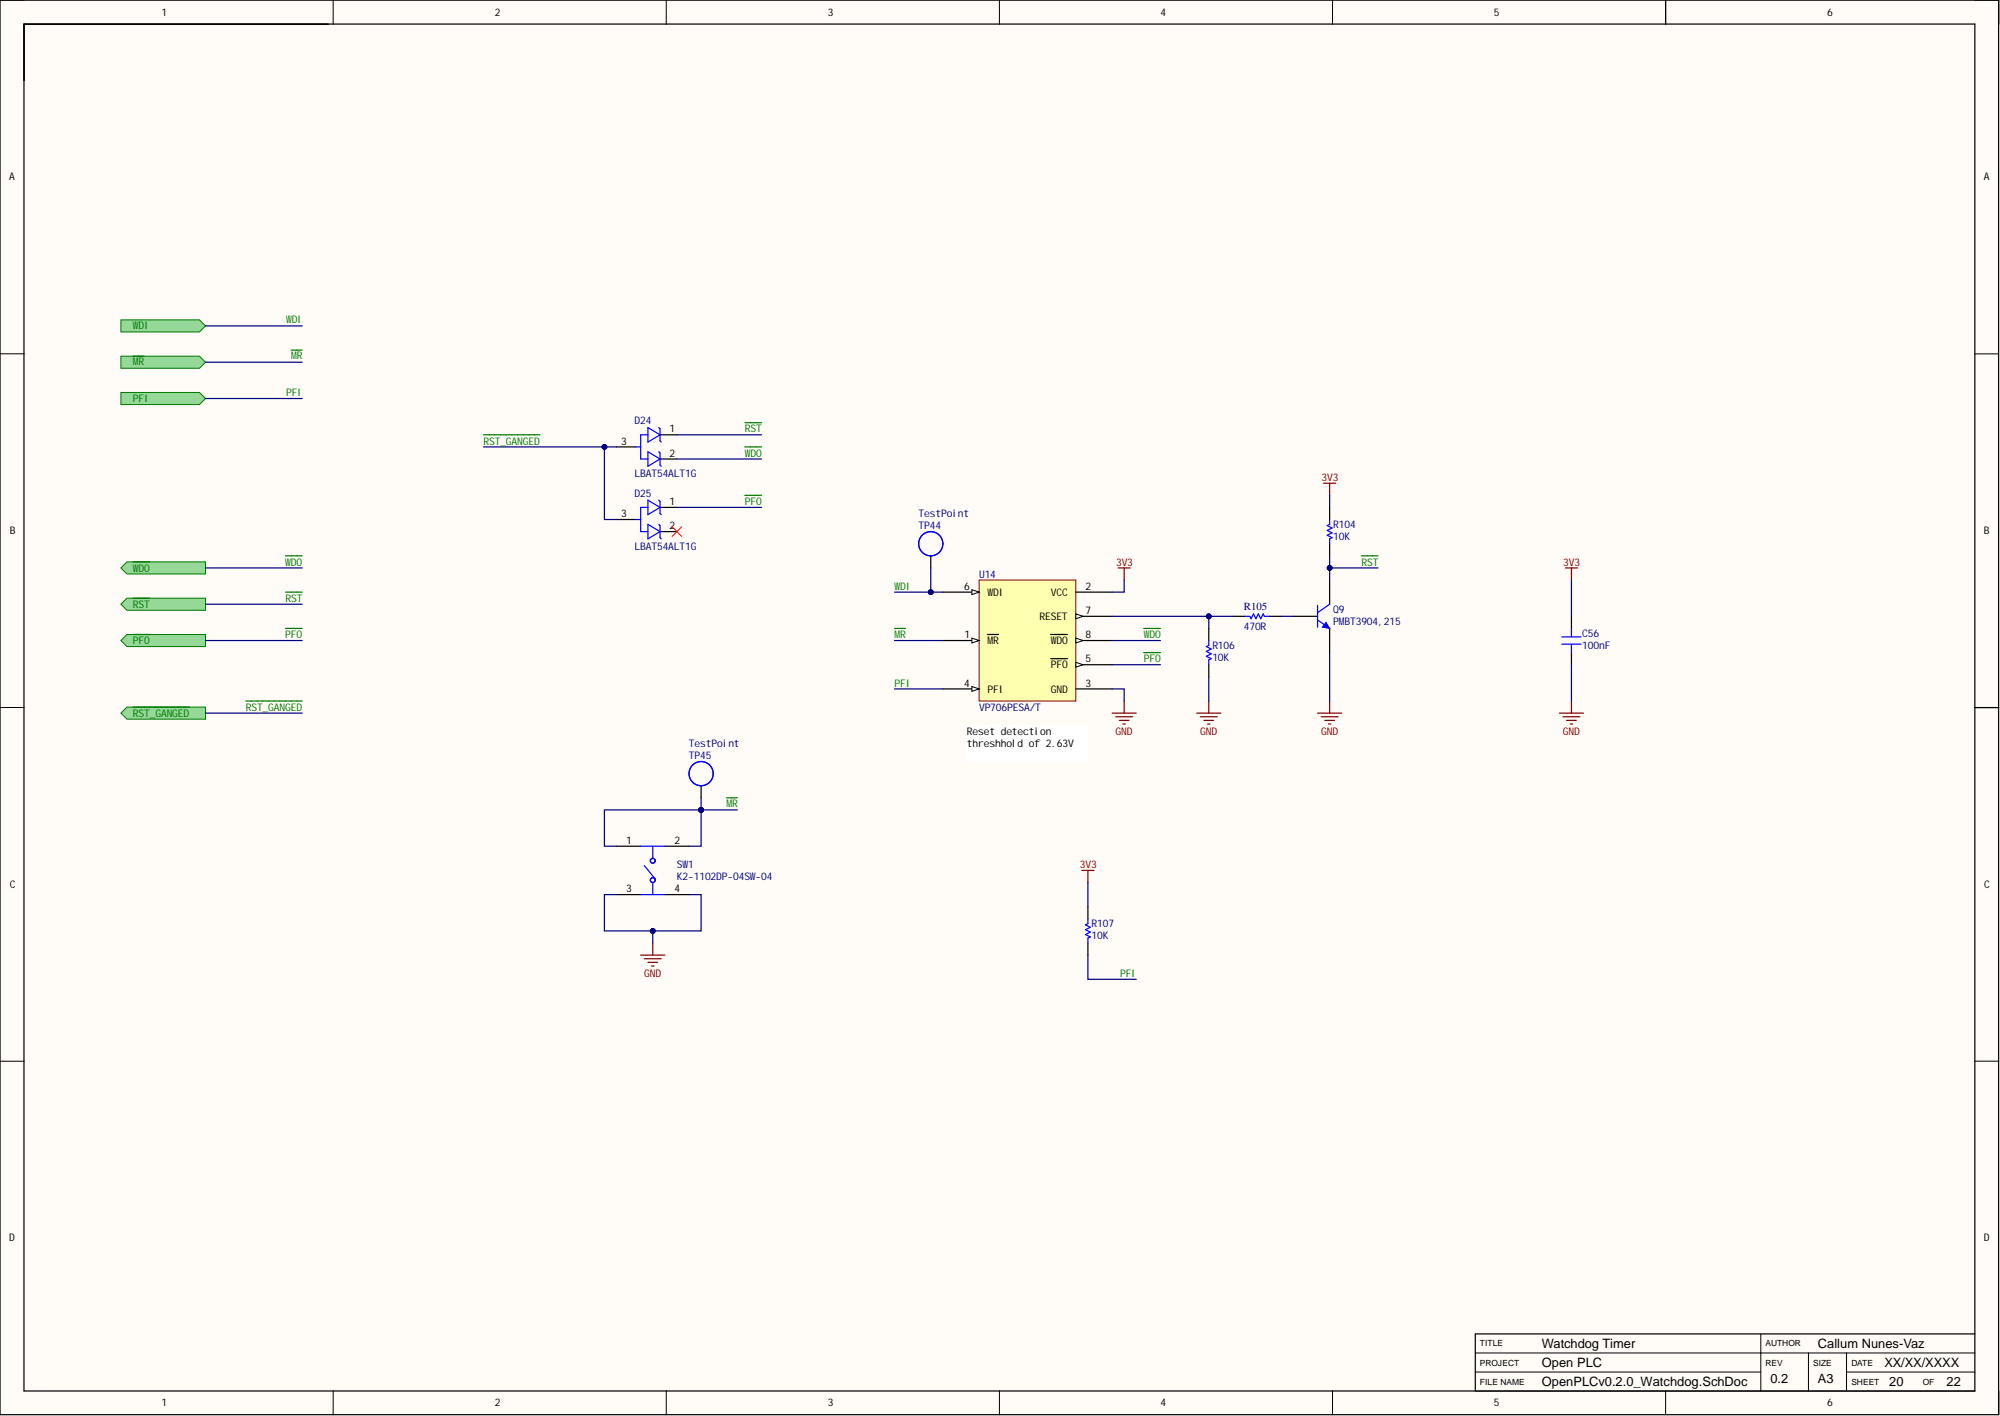
[picture p20: page 20]

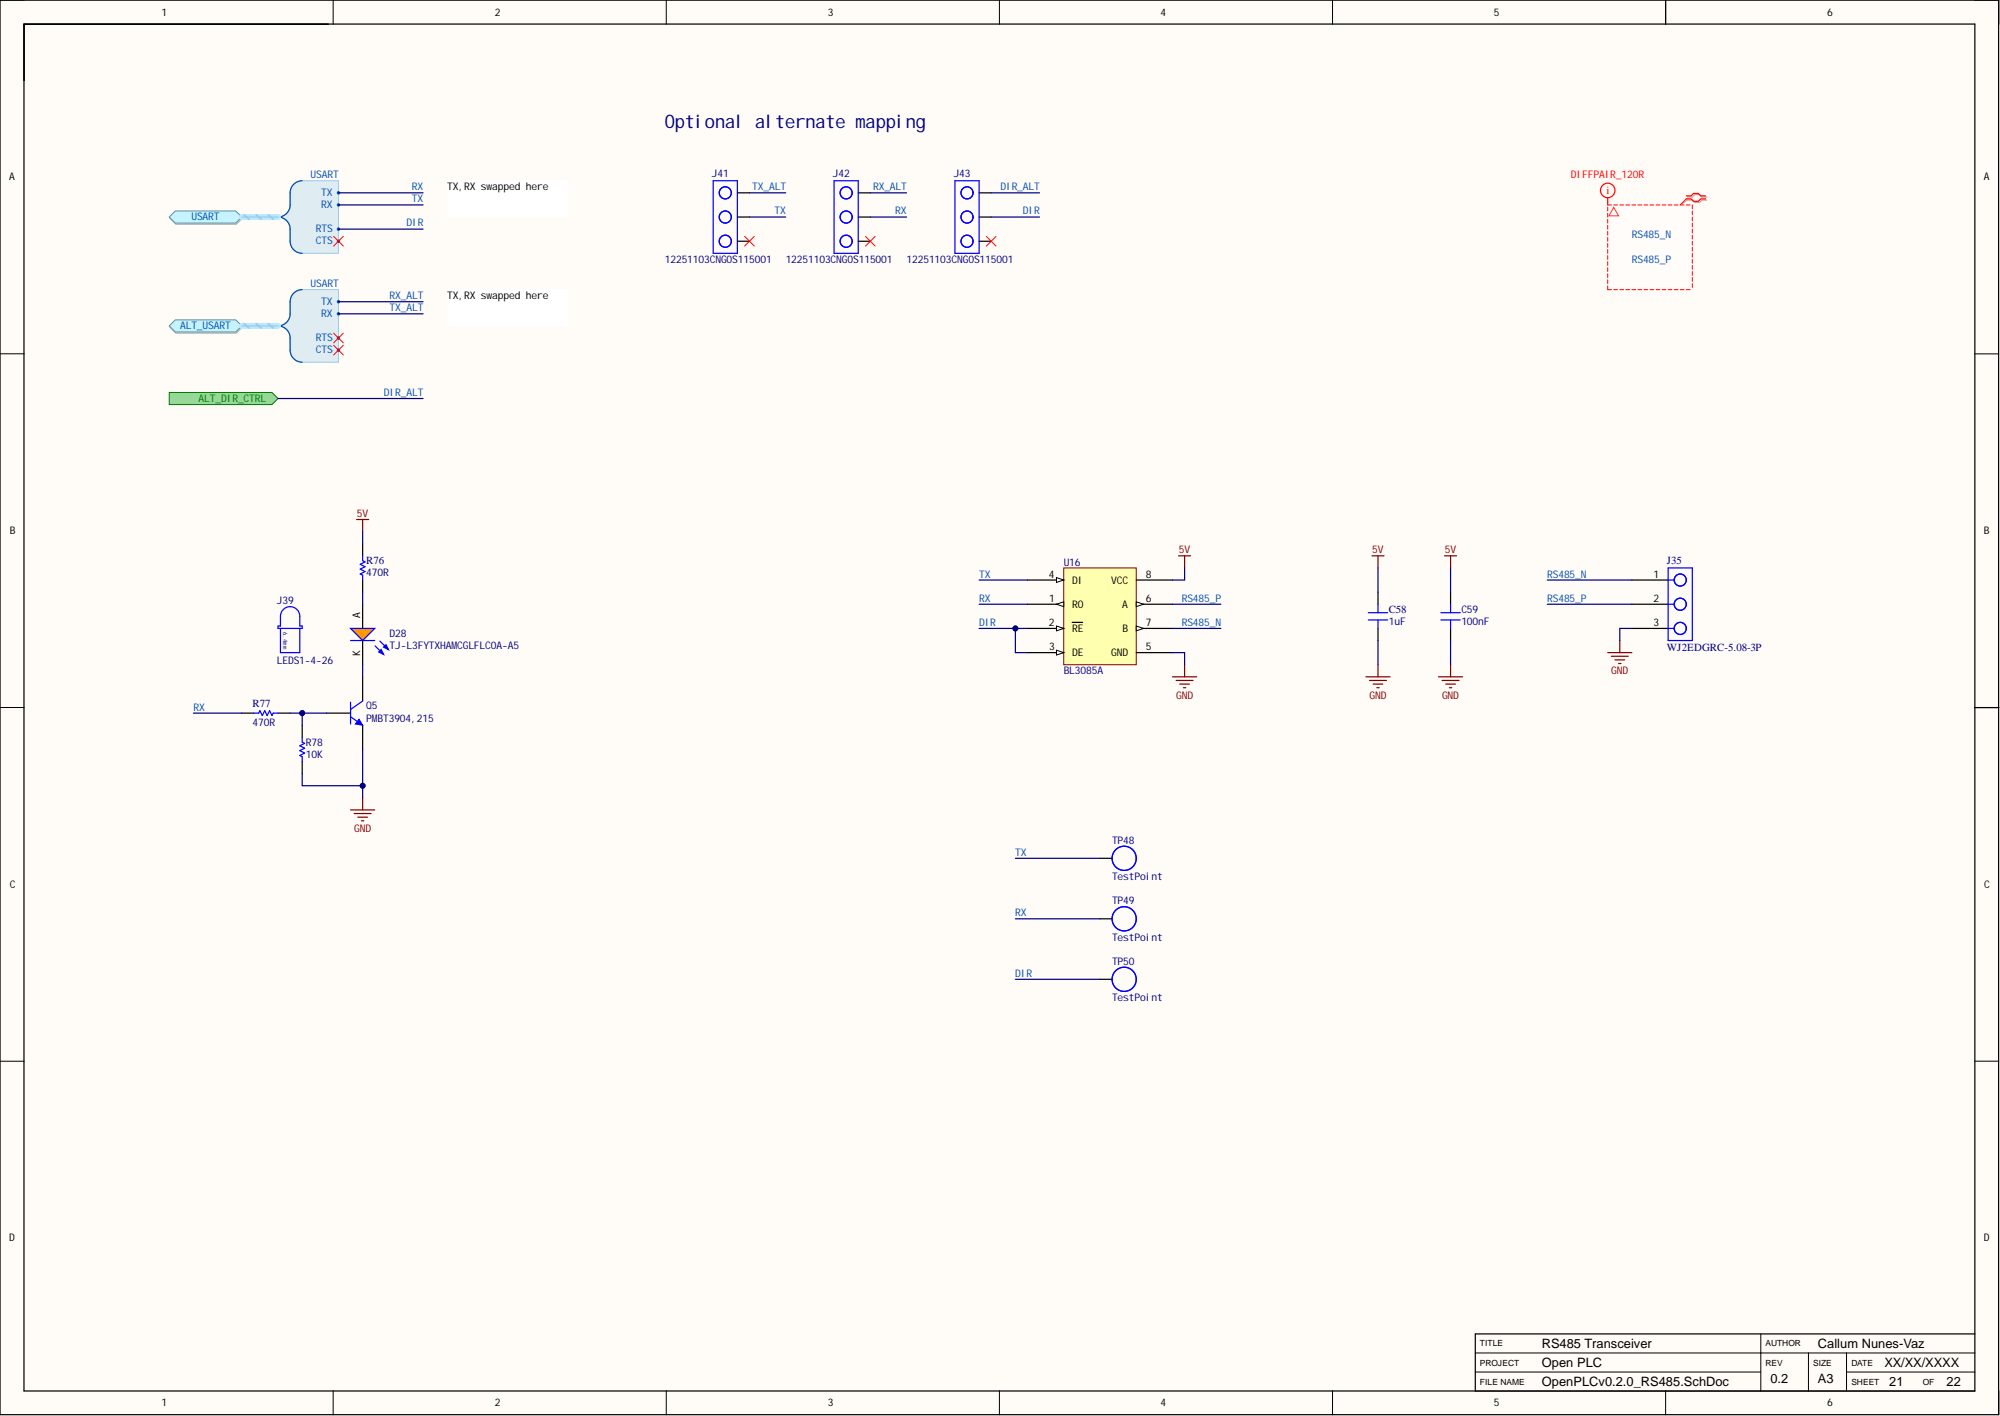
[picture p21: page 21]

TX,RX swapped here

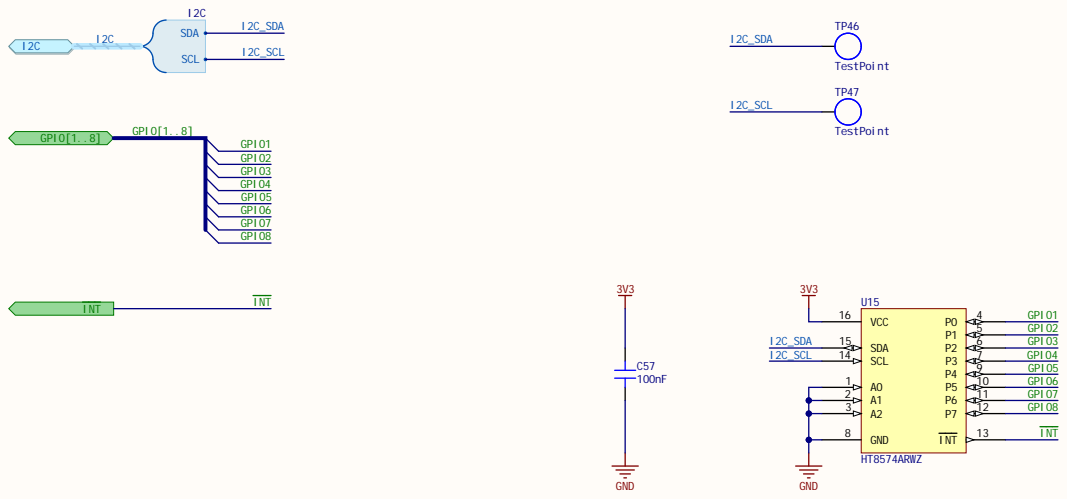
[picture p22: page 22]
