CallumNunesVaz/OpenController/Output/Assembly Data/OpenController_Assembly.PDF

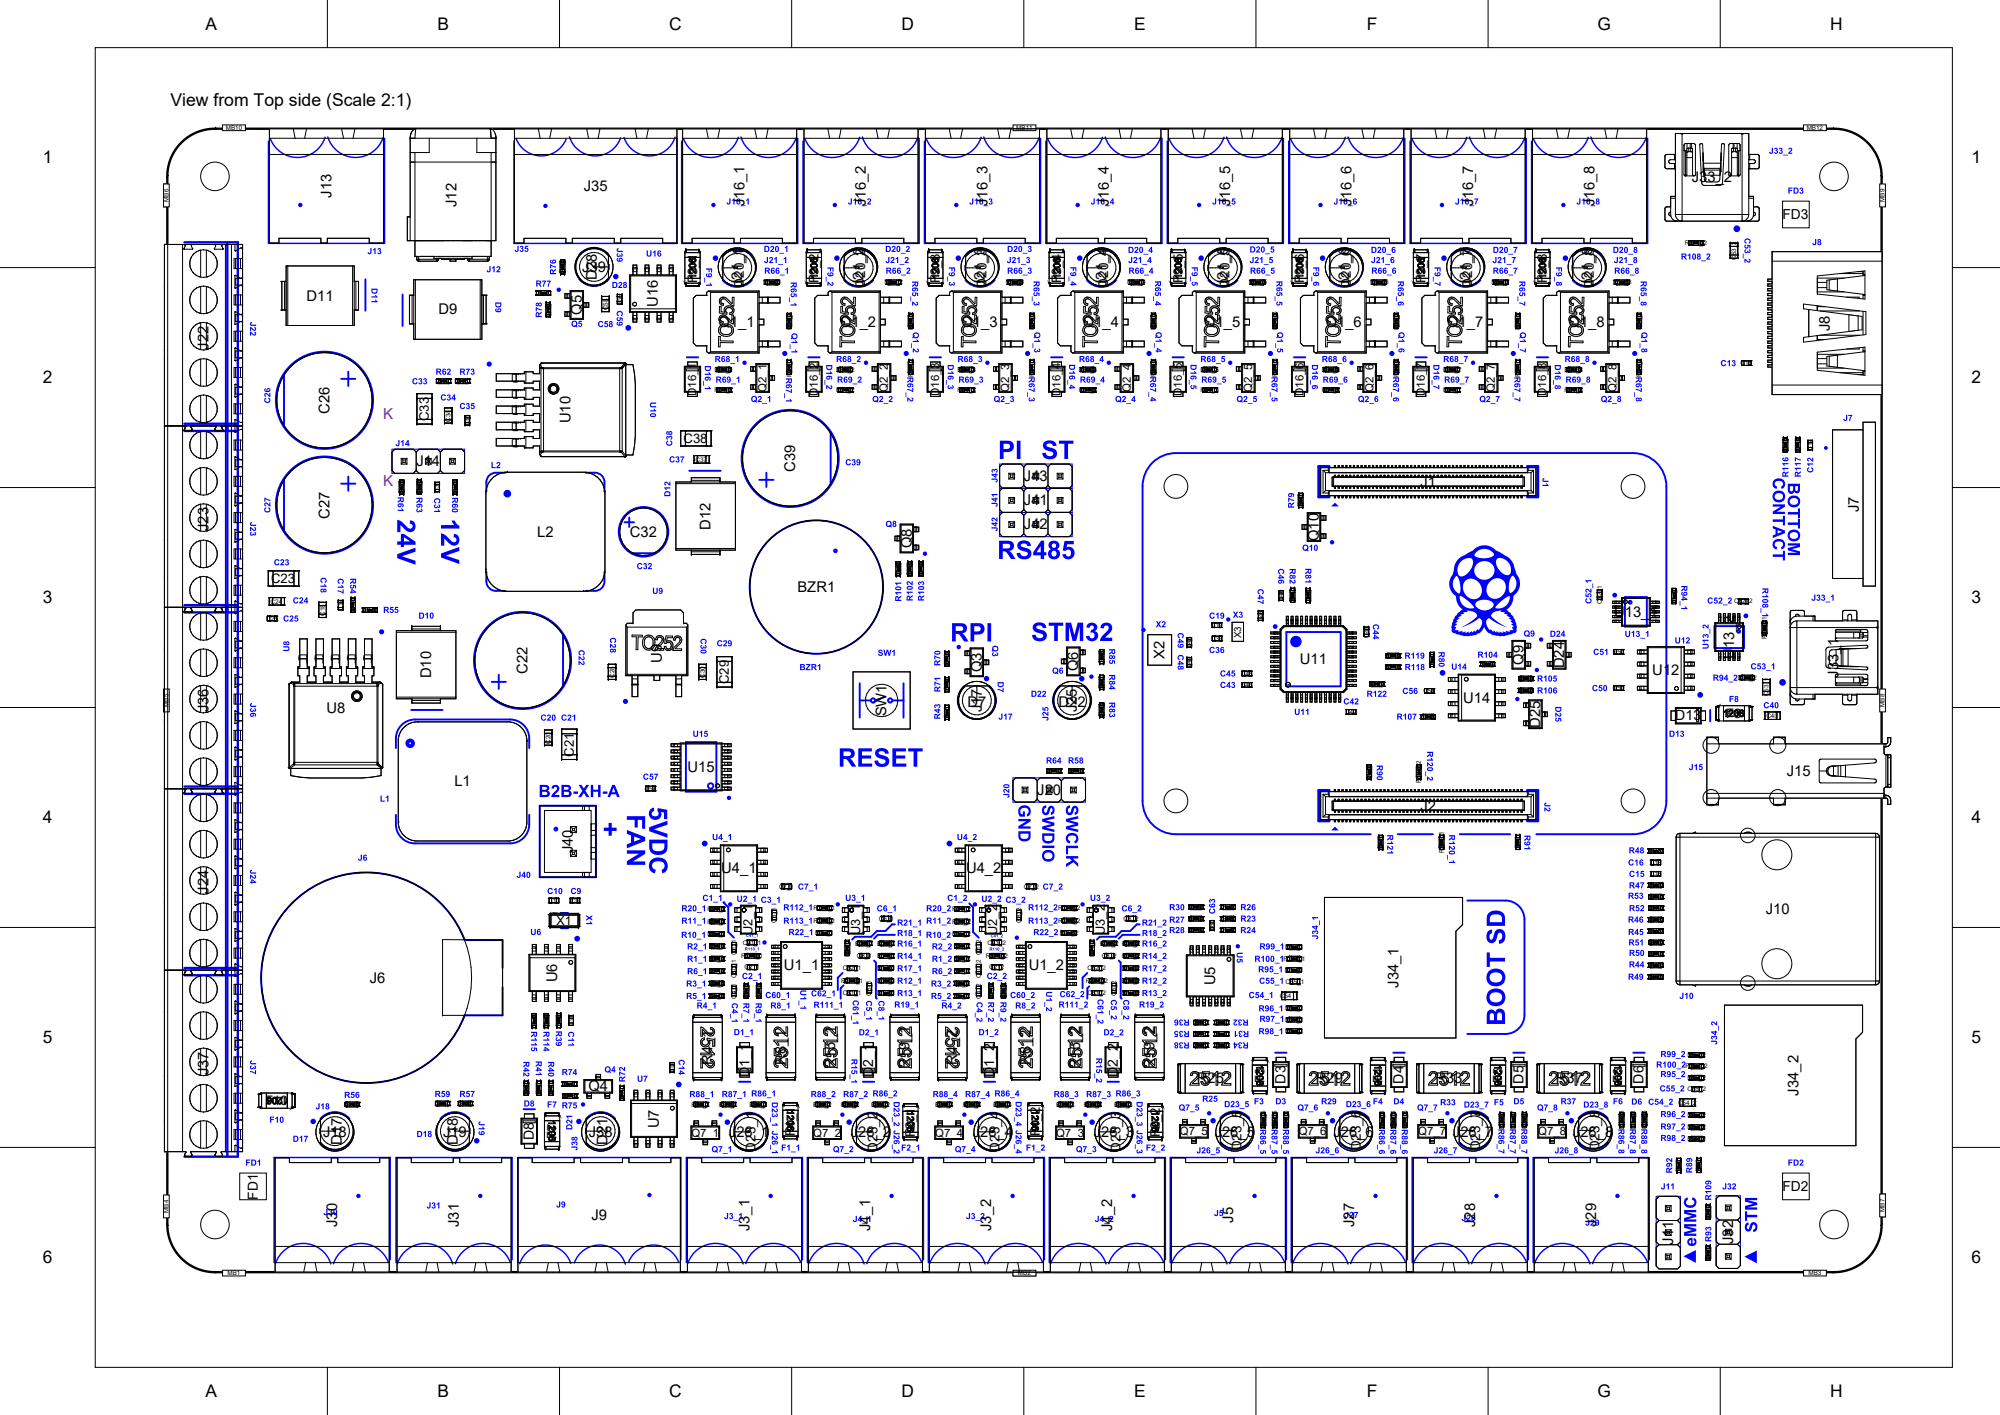
[picture p25: page 1]

View from Top side (Scale 2:1)
