CallumNunesVaz/OpenController/(list of files, drawings)

Other design files:
Altium/Brautomation_V2.PrjPcb
Altium/OpenPLCv0.2.0.PrjPcb
Altium/OpenPLCv0.2.0_1Wire.SchDoc
Altium/OpenPLCv0.2.0_AnalogueInput.SchDoc
Altium/OpenPLCv0.2.0_AnalogueOutput.SchDoc
Altium/OpenPLCv0.2.0_BinaryOut.SchDoc
Altium/OpenPLCv0.2.0_Buzzer.SchDoc
Altium/OpenPLCv0.2.0_Capacitor.SchLib
Altium/OpenPLCv0.2.0_ComputeModule.SchDoc
Altium/OpenPLCv0.2.0_Connector.PcbLib
Altium/OpenPLCv0.2.0_Connector.SchLib
Altium/OpenPLCv0.2.0_Diode.SchLib
Altium/OpenPLCv0.2.0_Discrete_SMD.PcbLib
Altium/OpenPLCv0.2.0_Display.SchDoc
Altium/OpenPLCv0.2.0_Etherent.SchDoc
Altium/OpenPLCv0.2.0_ExpansionHeader.SchDoc
Altium/OpenPLCv0.2.0_GPIOExpander.SchDoc
Altium/OpenPLCv0.2.0_IC.PcbLib
Altium/OpenPLCv0.2.0_IC.SchLib
Altium/OpenPLCv0.2.0_Inductor.SchLib
Altium/OpenPLCv0.2.0_IOController.SchDoc
Altium/OpenPLCv0.2.0_IOLED.SchDoc
Altium/OpenPLCv0.2.0_Misc.PcbLib
Altium/OpenPLCv0.2.0_Misc.SchLib
Altium/OpenPLCv0.2.0_PANEL.PcbDoc
Altium/OpenPLCv0.2.0_Passives.SchLib
Altium/OpenPLCv0.2.0_Power.SchDoc
Altium/OpenPLCv0.2.0_Relay.SchDoc
Altium/OpenPLCv0.2.0_Resistor.SchLib
Altium/OpenPLCv0.2.0_RS485.SchDoc
Altium/OpenPLCv0.2.0_RTC.SchDoc
Altium/OpenPLCv0.2.0_SDCard.SchDoc
Altium/OpenPLCv0.2.0_SerialInterface.SchDoc
Altium/OpenPLCv0.2.0_TopLevel.SchDoc
Altium/OpenPLCv0.2.0_Transistor.SchLib
Altium/OpenPLCv0.2.0_USBPortTypeA.SchDoc
Altium/OpenPLCv0.2.0_USBPortTypeB.SchDoc
Altium/OpenPLCv0.2.0_USBSwitch.SchDoc
Altium/OpenPLCv0.2.0_Watchdog.SchDoc
