CallumNunesVaz/OpenController/(commit log)

2021-07-22 Changed filenames
    [BrauV2_1Wire.SchDoc, BrauV2_AnalogueInput.SchDoc, BrauV2_AnalogueOutput.SchDoc, BrauV2_Power.SchDoc, BrauV2_TopLevel.SchDoc, OpenPLCv0.2.0.PrjPcb, OpenPLCv0.2.0_1Wire.SchDoc, OpenPLCv0.2.0_AnalogueInput.SchDoc]
2021-07-22 Changed filenames of unused files
    [OpenPLCv0.2.0_Relay.SchDoc]
2021-07-22 Updated stackup for diff routing. Some draft component placement. Fixed various schem template issues.
    [OpenPLCv0.2.0.PrjPcb, OpenPLCv0.2.0_1Wire.SchDoc, OpenPLCv0.2.0_AnalogueInput.SchDoc, OpenPLCv0.2.0_AnalogueOutput.SchDoc, OpenPLCv0.2.0_BinaryOut.SchDoc, OpenPLCv0.2.0_Buzzer.SchDoc, OpenPLCv0.2.0_ComputeModule.SchDoc, OpenPLCv0.2.0_Connector.PcbLib]
2021-07-24 Drafted board layout
    [OpenPLCv0.2.0_Connector.PcbLib, OpenPLCv0.2.0_Connector.SchLib, OpenPLCv0.2.0_ExpansionHeader.SchDoc, OpenPLCv0.2.0_Power.SchDoc, OpenPLCv0.2.0_TopLevel.SchDoc]
2021-07-24 Completed first draft power layout
    [OpenPLCv0.2.0_Buzzer.SchDoc, OpenPLCv0.2.0_Connector.PcbLib, OpenPLCv0.2.0_IC.PcbLib, OpenPLCv0.2.0_Misc.PcbLib, OpenPLCv0.2.0_Power.SchDoc]
2021-07-24 Changed buzzer
    [OpenPLCv0.2.0_Connector.PcbLib, OpenPLCv0.2.0_Connector.SchLib, OpenPLCv0.2.0_Power.SchDoc, OpenPLCv0.2.0_RTC.SchDoc]
2021-07-24 Changed board size. 115x175mm
    [OpenPLCv0.2.0.PrjPcb, OpenPLCv0.2.0_ExpansionHeader.SchDoc, OpenPLCv0.2.0_IOController.SchDoc, OpenPLCv0.2.0_TopLevel.SchDoc, OpenPLCv0.2.0_Watchdog.SchDoc]
2021-07-24 Added orange LEDs to 1Wire and RS485
    [OpenPLCv0.2.0_1Wire.SchDoc, OpenPLCv0.2.0_RS485.SchDoc, OpenPLCv0.2.0_Transistor.SchLib]
2021-07-25 Made STM arduino compatible. Changed boot logic. Completed draft layout. Removed redundant parts.
    [OpenPLCv0.2.0_IC.PcbLib, OpenPLCv0.2.0_IOController.SchDoc, OpenPLCv0.2.0_Power.SchDoc, OpenPLCv0.2.0_TopLevel.SchDoc, OpenPLCv0.2.0_USBPortTypeA.SchDoc]
2021-07-27 Updated output docs
    [Bill of Materials-OpenPLCv0.2.0.csv, Bill of Materials-OpenPLCv0.2.0.xlsx, OpenPLCv0.2.0_Connector.SchLib, OpenPLCv0.2.0_PANEL.PcbDoc]
2021-07-29 Added LPF to AOUT input. Added prog header for STM32.
    [OpenPLCv0.2.0_AnalogueOutput.SchDoc, OpenPLCv0.2.0_IOController.SchDoc]
2021-08-09 Added bottom-side test point pads for nets not available on through-hole pins
    [OpenPLCv0.2.0_1Wire.SchDoc, OpenPLCv0.2.0_AnalogueInput.SchDoc, OpenPLCv0.2.0_AnalogueOutput.SchDoc, OpenPLCv0.2.0_BinaryOut.SchDoc, OpenPLCv0.2.0_Buzzer.SchDoc, OpenPLCv0.2.0_GPIOExpander.SchDoc, OpenPLCv0.2.0_IOController.SchDoc, OpenPLCv0.2.0_Misc.PcbLib]
2021-08-11 Draft placement of some testing pads
    [OpenPLCv0.2.0_USBPortTypeB.SchDoc, OpenPLCv0.2.0_USBSwitch.SchDoc]
2021-08-12 Placed test points. Placed AO discretes. Draft routing.
    [OpenPLCv0.2.0_1Wire.SchDoc, OpenPLCv0.2.0_AnalogueInput.SchDoc, OpenPLCv0.2.0_AnalogueOutput.SchDoc, OpenPLCv0.2.0_BinaryOut.SchDoc, OpenPLCv0.2.0_ComputeModule.SchDoc, OpenPLCv0.2.0_IOController.SchDoc, OpenPLCv0.2.0_IOLED.SchDoc, OpenPLCv0.2.0_RS485.SchDoc]
2021-08-13 AOUT tuned for DAC. Progress in draft routing.
    [OpenPLCv0.2.0_AnalogueOutput.SchDoc]
2021-08-14 Added fan header. Replaced DSI connector. Fixed incorrect routing.
    [OpenPLCv0.2.0_ComputeModule.SchDoc, OpenPLCv0.2.0_Connector.PcbLib, OpenPLCv0.2.0_Connector.SchLib, OpenPLCv0.2.0_Display.SchDoc, OpenPLCv0.2.0_ExpansionHeader.SchDoc, OpenPLCv0.2.0_IOController.SchDoc, OpenPLCv0.2.0_RTC.SchDoc, OpenPLCv0.2.0_TopLevel.SchDoc]
2021-08-14 Added new clearance rules for matched traces
    [OpenPLCv0.2.0.PrjPcb, OpenPLCv0.2.0_ComputeModule.SchDoc, OpenPLCv0.2.0_SDCard.SchDoc, OpenPLCv0.2.0_USBPortTypeB.SchDoc]
2021-08-15 Adjusted rule set for routing clearance, height clearance. Added notes. Adjusted libs for height data.
    [OpenPLCv0.2.0.PrjPcb, OpenPLCv0.2.0_Display.SchDoc, OpenPLCv0.2.0_IC.PcbLib]
2021-08-16 Added more rules for 50R matching and special net considerations.
    [OpenPLCv0.2.0_ComputeModule.SchDoc, OpenPLCv0.2.0_ExpansionHeader.SchDoc, OpenPLCv0.2.0_IOController.SchDoc, OpenPLCv0.2.0_SDCard.SchDoc, OpenPLCv0.2.0_TopLevel.SchDoc]
2021-08-17 Fixed room name error. More draft routing.
    [OpenPLCv0.2.0_SDCard.SchDoc]
2021-09-17 Increased board size to allow easier mech design. Added 3D body pair to mech layer stackup.
    [OpenPLCv0.2.0_Connector.PcbLib, OpenPLCv0.2.0_Discrete_SMD.PcbLib, OpenPLCv0.2.0_IC.PcbLib, OpenPLCv0.2.0_Misc.PcbLib]
2021-09-17 Adjusted board stackup. Some draft routing.
    [OpenPLCv0.2.0_Capacitor.SchLib, OpenPLCv0.2.0_Misc.PcbLib, OpenPLCv0.2.0_Power.SchDoc]
2021-09-18 Added jumper to select for RS485 passthrough to STM32. More draft routing.
    [OpenPLCv0.2.0_AnalogueInput.SchDoc, OpenPLCv0.2.0_IOController.SchDoc, OpenPLCv0.2.0_RS485.SchDoc, OpenPLCv0.2.0_TopLevel.SchDoc]
2021-09-24 Added diff pair definiton for RS485. More draft routing.
    [OpenPLCv0.2.0_RS485.SchDoc, OpenPLCv0.2.0_TopLevel.SchDoc]
2021-09-25 More draft routing. Renamed RS485 diff pair def.
    [OpenPLCv0.2.0_RS485.SchDoc]
2021-09-25 More draft routing.
    [OpenPLCv0.2.0_IOController.SchDoc]
2021-12-05 More draft routing. Added descriptors to rules. Neatend rule definitions.
    [OpenPLCv0.2.0.PrjPcb]
2021-12-05 Changed power source for some LEDs. More routing.
    [OpenPLCv0.2.0.PrjPcb, OpenPLCv0.2.0_ComputeModule.SchDoc, OpenPLCv0.2.0_IOController.SchDoc]
2021-12-11 More routing. Fixed schematic error on compute module supply net.
    [OpenPLCv0.2.0_ComputeModule.SchDoc]
2022-01-22 Draft routing. Adjusted draftsman docs.
    [OpenPLCv0.2.0.PrjPcb]
2022-01-22 Fixed some rules. More routing. Length matching.
    [OpenPLCv0.2.0_1Wire.SchDoc, OpenPLCv0.2.0_AnalogueInput.SchDoc, OpenPLCv0.2.0_AnalogueOutput.SchDoc, OpenPLCv0.2.0_BinaryOut.SchDoc, OpenPLCv0.2.0_Connector.PcbLib, OpenPLCv0.2.0_Connector.SchLib, OpenPLCv0.2.0_ExpansionHeader.SchDoc, OpenPLCv0.2.0_Power.SchDoc]
2022-01-22 Fixed some silk errors
    [Bill of Materials-OpenPLCv0.2.0.csv, Bill of Materials-OpenPLCv0.2.0.xlsx]
2022-02-06 More draft routing. Fixed some rules.
    [OpenPLCv0.2.0_ComputeModule.SchDoc, OpenPLCv0.2.0_Etherent.SchDoc, OpenPLCv0.2.0_TopLevel.SchDoc]
2022-02-08 Added fiducials. Thickened some traces. Neatened some things.
    [OpenPLCv0.2.0_Misc.PcbLib, OpenPLCv0.2.0_Misc.SchLib, OpenPLCv0.2.0_TopLevel.SchDoc]
2022-02-10 Finalised a draft routing. Panelised.
    [OpenPLCv0.2.0_Misc.PcbLib, OpenPLCv0.2.0_Misc.SchLib, OpenPLCv0.2.0_PANEL.PcbDoc, OpenPLCv0.2.0_TopLevel.SchDoc]
2022-02-10 Added diff pair definitoins as mechanical layers
    [OpenPLCv0.2.0_PANEL.PcbDoc]
2022-02-10 Checked analogue output circuit sim
    [OpenPLCv0.2.0_AnalogueOutput.SchDoc]
2022-02-10 Added sheet title to all sheets
    [OpenPLCv0.2.0_1Wire.SchDoc, OpenPLCv0.2.0_AnalogueInput.SchDoc, OpenPLCv0.2.0_AnalogueOutput.SchDoc, OpenPLCv0.2.0_BinaryOut.SchDoc, OpenPLCv0.2.0_Buzzer.SchDoc, OpenPLCv0.2.0_ComputeModule.SchDoc, OpenPLCv0.2.0_Display.SchDoc, OpenPLCv0.2.0_Etherent.SchDoc]
2022-02-12 Created output data for ordering
    [Bill of Materials-OpenPLCv0.2.0(Basic).csv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]
2022-02-12 Generated more output documentation
    [OpenPLCv0.2.0.PrjPcb]
2022-03-19 Added image of assembled board
